deltaxrobot/Delta-X-3D-Printed-Parts/Delta-X-Robot/Delta X 1 - MainBox V2-1.STL

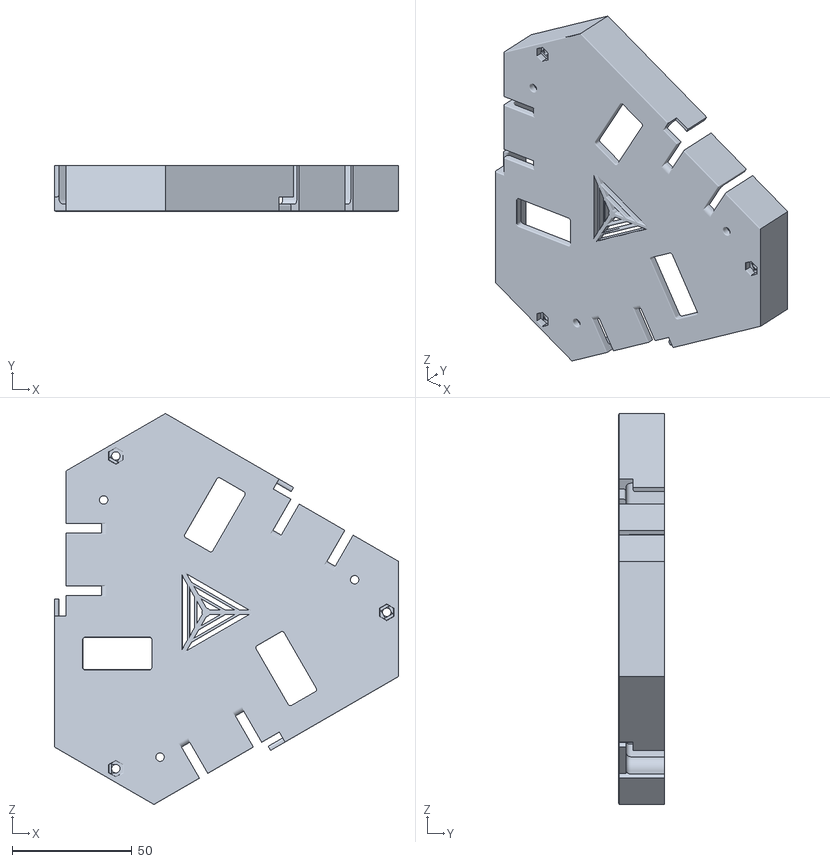
[picture p1: CAD file, 2022-04-01]
Delta-X-Robot/Delta X 1 - MainBox V2-1.STL
143.8 x 19.0 x 163.3
