deltaxrobot/Delta-X-3D-Printed-Parts/Delta-X-Robot/Delta X 1 - MainBoxLid V2-1.STL

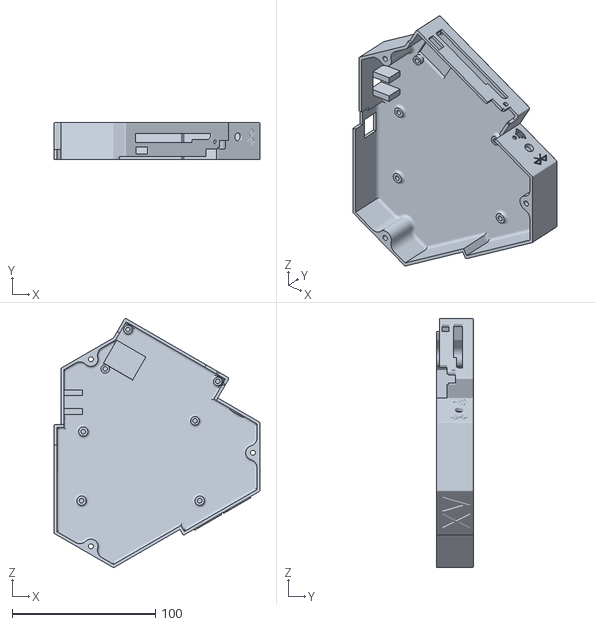
[picture p2: CAD file, 2022-04-01]
Delta-X-Robot/Delta X 1 - MainBoxLid V2-1.STL
143.8 x 25.8 x 173.8
