deltaxrobot/Delta-X-3D-Printed-Parts/Conveyor-X/RollerAxisHolder-Mirror.STL

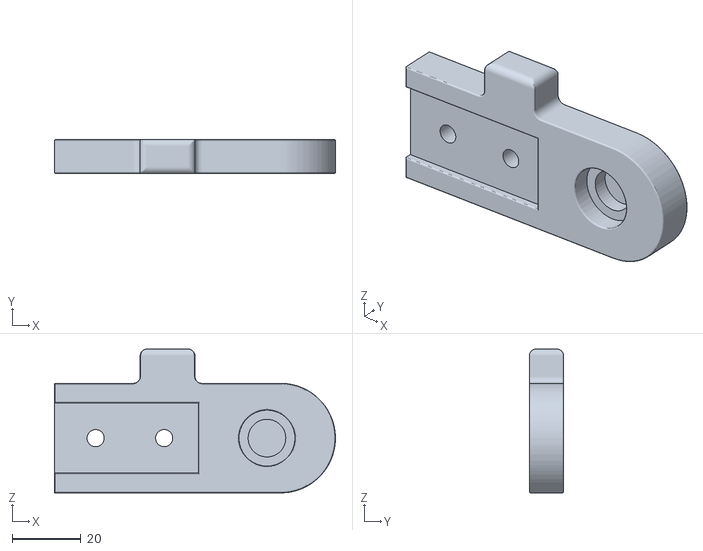
[picture p3: CAD file, 2023-01-11]
Conveyor-X/RollerAxisHolder-Mirror.STL
82.0 x 10.0 x 42.0
