deltaxrobot/Delta-X-3D-Printed-Parts/Delta-X-End-Effectors/Axis4 - Gripper/Axis4 Gripper Lib.STL

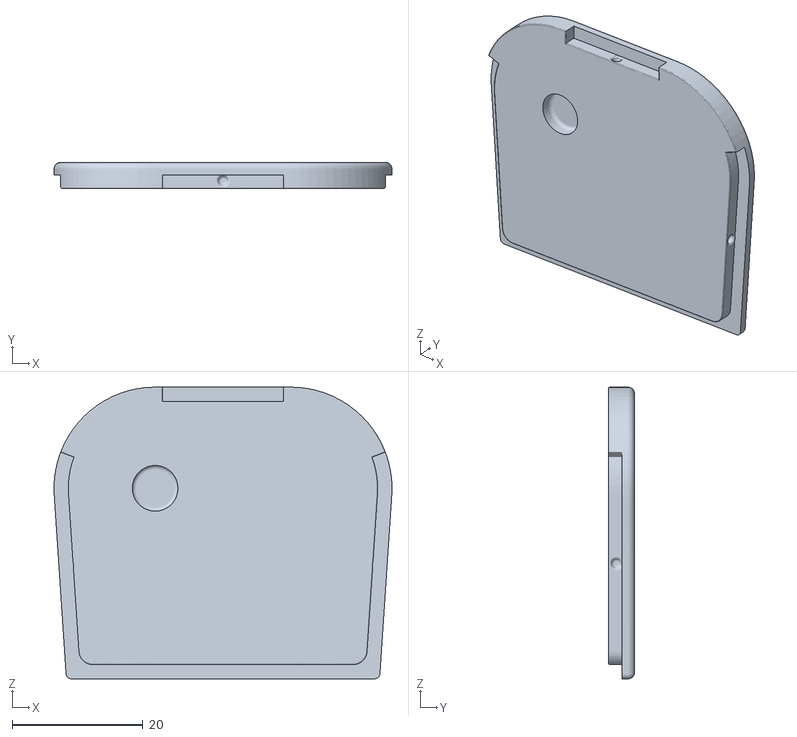
[picture p4: CAD file, 2020-04-02]
Delta-X-End-Effectors/Axis4 - Gripper/Axis4 Gripper Lib.STL
51.8 x 4.00 x 44.7
