deltaxrobot/Delta-X-3D-Printed-Parts/Delta-X-End-Effectors/Axis4 - Gripper/v2/Base-2.stl

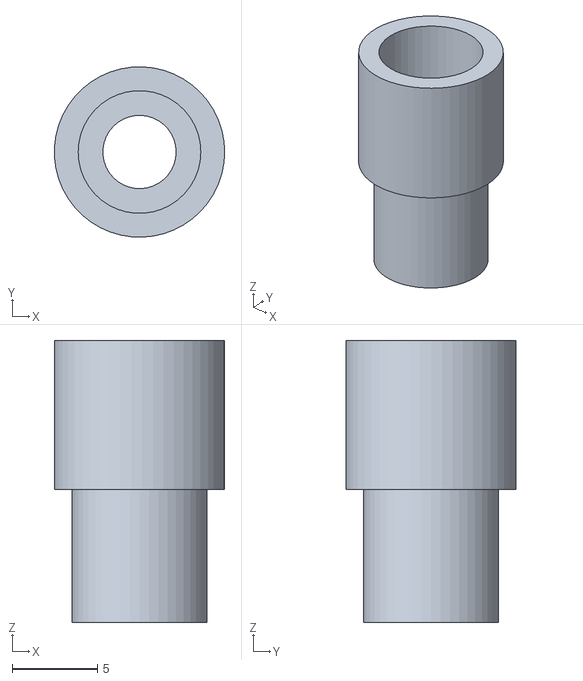
[picture p5: CAD file, 2023-02-06]
Delta-X-End-Effectors/Axis4 - Gripper/v2/Base-2.stl
10.0 x 9.99 x 16.6
