deltaxrobot/Delta-X-3D-Printed-Parts/Delta-X-End-Effectors/Flexible Gripper/Flexible Gripper _ 2 _plastic 3.STL

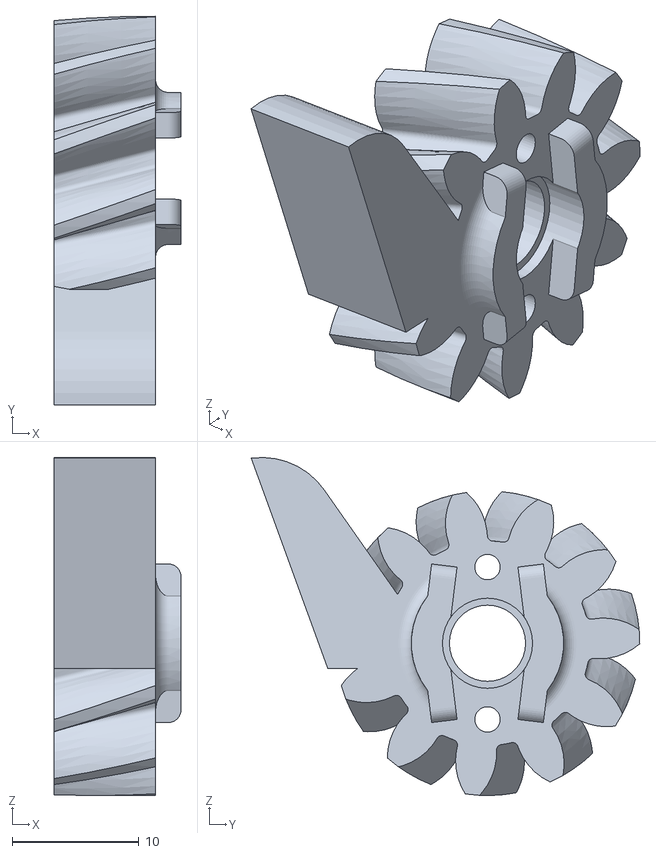
[picture p6: CAD file, 2020-04-02]
Delta-X-End-Effectors/Flexible Gripper/Flexible Gripper _ 2 _plastic 3.STL
10.00 x 30.6 x 26.6
