deltaxrobot/Delta-X-3D-Printed-Parts/Delta-X-End-Effectors/v2/Step-file/Pen Holder 2.STL

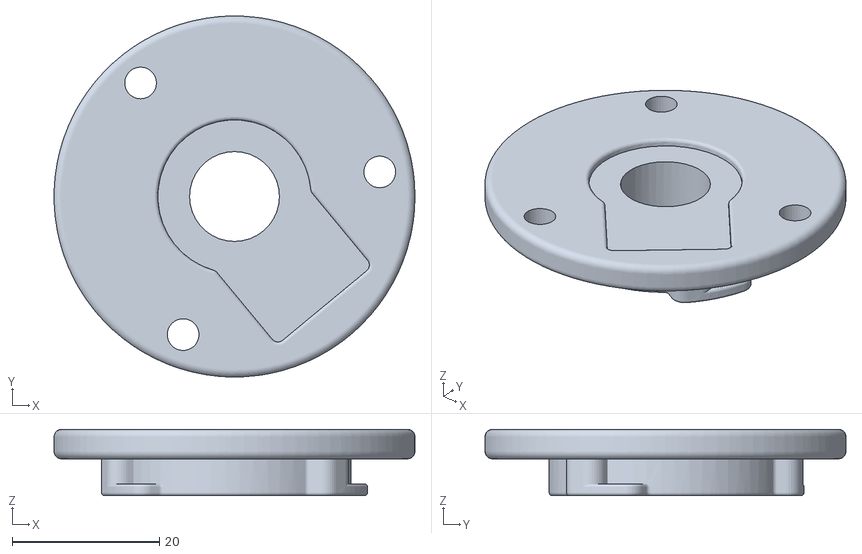
[picture p7: CAD file, 2024-02-09]
Delta-X-End-Effectors/v2/Step-file/Pen Holder 2.STL
49.0 x 49.0 x 9.00
