deltaxrobot/Delta-X-3D-Printed-Parts/Delta-X-End-Effectors/Vacuum/VaccumBox _1 .STL

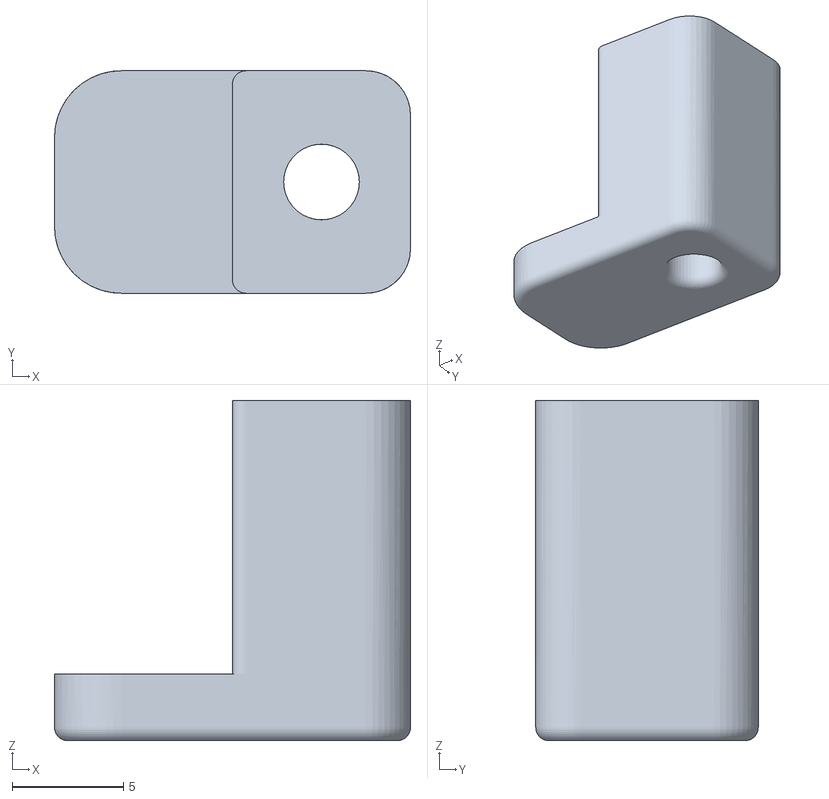
[picture p8: CAD file, 2020-04-02]
Delta-X-End-Effectors/Vacuum/VaccumBox _1 .STL
16.0 x 10.0 x 15.3
