deltaxrobot/Delta-X-3D-Printed-Parts/Delta-X-Robot/Delta X 1 - BeltTensioner2-2.STL

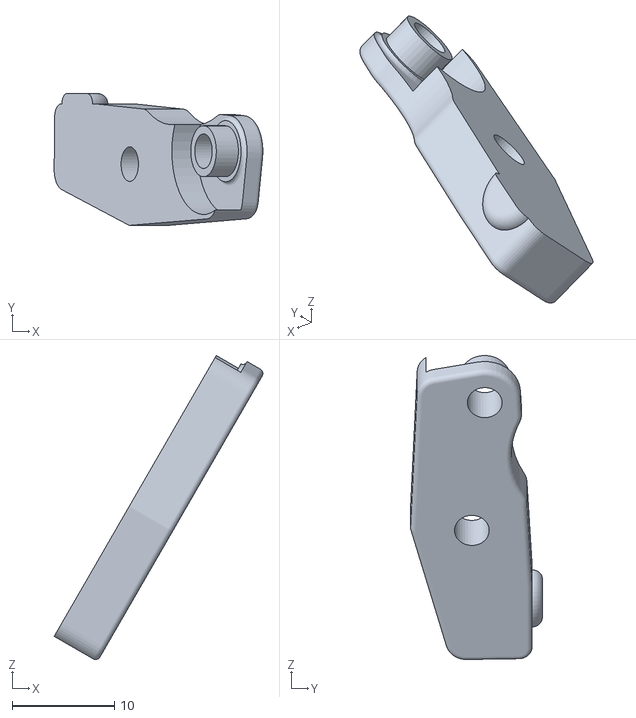
[picture p9: CAD file, 2022-04-01]
Delta-X-Robot/Delta X 1 - BeltTensioner2-2.STL
20.4 x 12.9 x 29.8
