deltaxrobot/Delta-X-3D-Printed-Parts/Slider-X/WheelHolder-1.STL

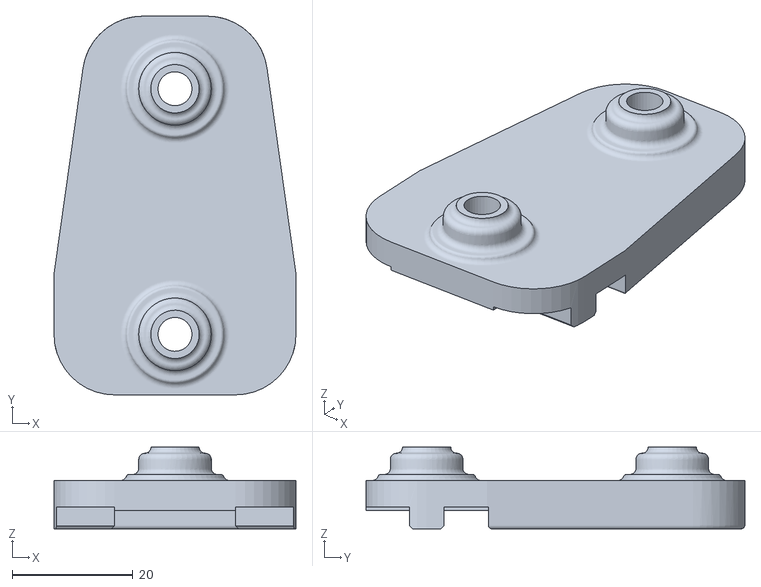
[picture p10: CAD file, 2023-01-11]
Slider-X/WheelHolder-1.STL
40.0 x 62.6 x 13.5
