deltaxrobot/Delta-X-3D-Printed-Parts/TripodBase.stl

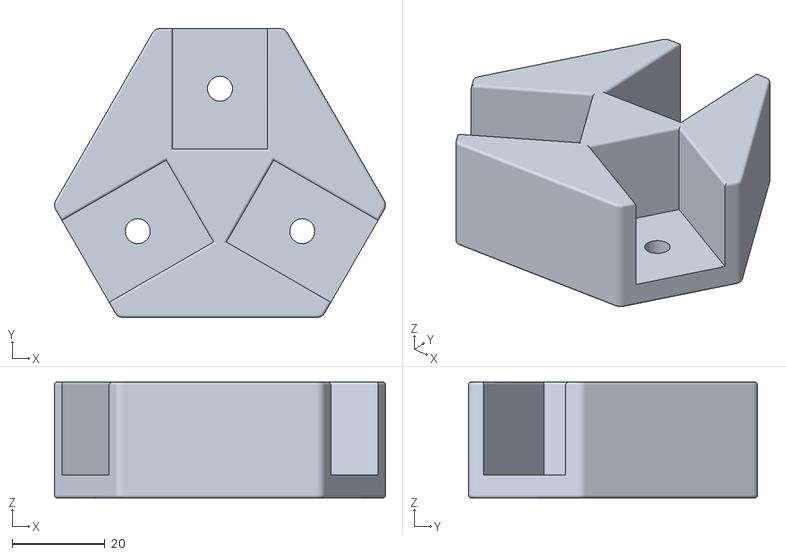
[picture p11: CAD file, 2024-03-16]
TripodBase.stl
71.4 x 62.4 x 25.0
