deltaxrobot/Delta-X-3D-Printed-Parts/Delta-X-End-Effectors/Axis4 - Gripper/v2/VaccumBase-SV.STL

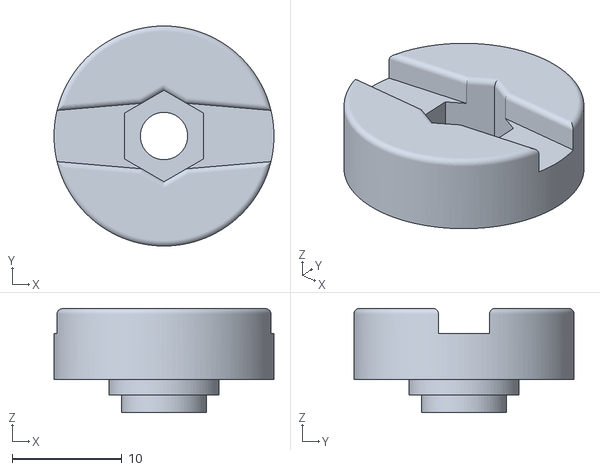
[picture p13: CAD file, 2023-02-06]
Delta-X-End-Effectors/Axis4 - Gripper/v2/VaccumBase-SV.STL
20.0 x 20.0 x 9.50
