deltaxrobot/Delta-X-3D-Printed-Parts/Delta-X-End-Effectors/Flexible Gripper/Flexible Gripper _ 2 _plastic.STL

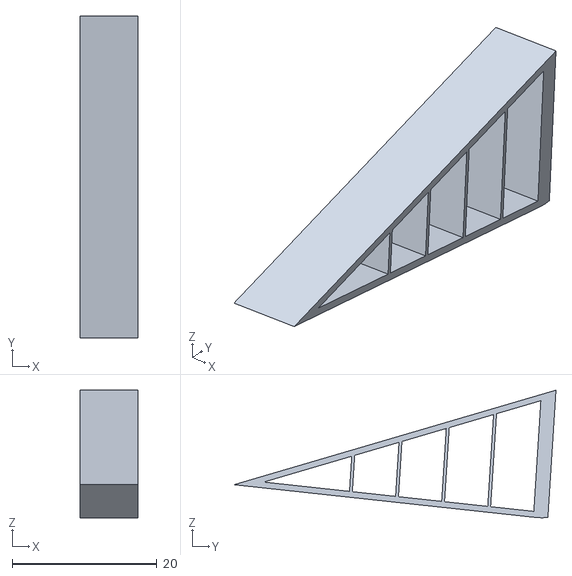
[picture p14: CAD file, 2020-04-02]
Delta-X-End-Effectors/Flexible Gripper/Flexible Gripper _ 2 _plastic.STL
8.00 x 44.5 x 17.7
