deltaxrobot/Delta-X-3D-Printed-Parts/Delta-X-End-Effectors/v2/Step-file/Pen Holder 1.STL

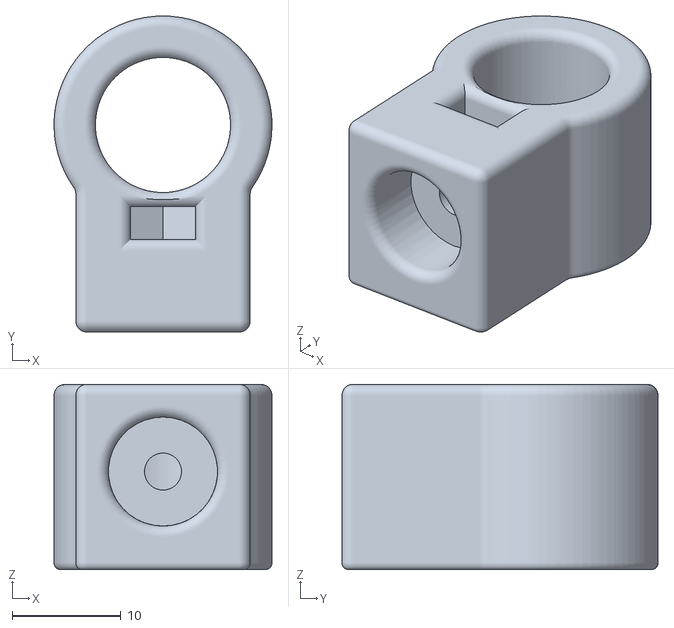
[picture p15: CAD file, 2024-02-09]
Delta-X-End-Effectors/v2/Step-file/Pen Holder 1.STL
20.0 x 29.0 x 17.0
