deltaxrobot/Delta-X-3D-Printed-Parts/Delta-X-End-Effectors/Vacuum/Axis4 - Vacuum Lib.STL

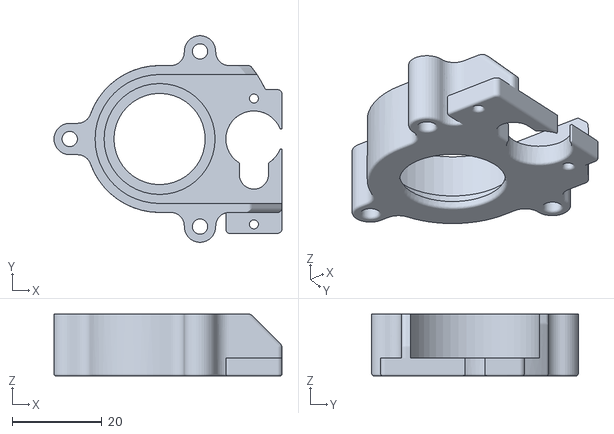
[picture p16: CAD file, 2020-04-02]
Delta-X-End-Effectors/Vacuum/Axis4 - Vacuum Lib.STL
50.8 x 46.0 x 13.8
