deltaxrobot/Delta-X-3D-Printed-Parts/Slider-X/RollerHolder.STL

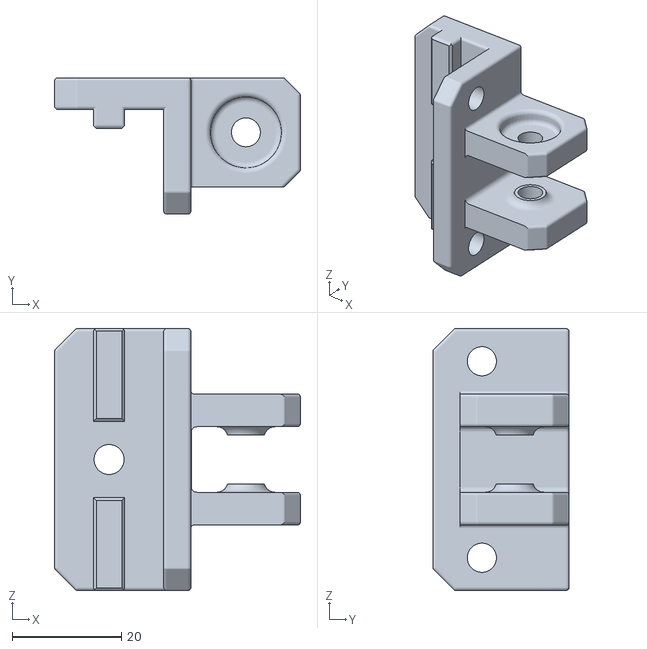
[picture p17: CAD file, 2023-01-11]
Slider-X/RollerHolder.STL
45.1 x 25.0 x 48.0
