deltaxrobot/Delta-X-3D-Printed-Parts/Conveyor-X/Adjust-Tool.STL

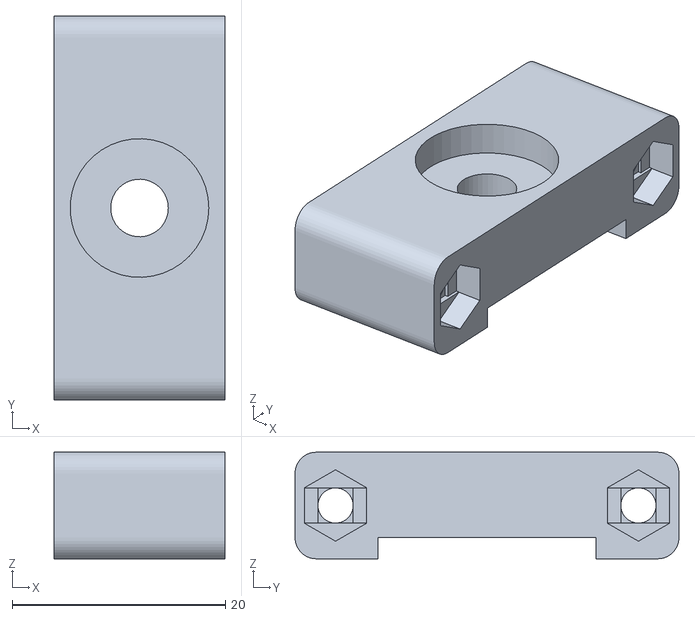
[picture p18: CAD file, 2023-01-11]
Conveyor-X/Adjust-Tool.STL
16.0 x 36.0 x 10.0
