deltaxrobot/Delta-X-3D-Printed-Parts/Delta-X-End-Effectors/Axis4 - Gripper/Axis4 Gripper Box.STL

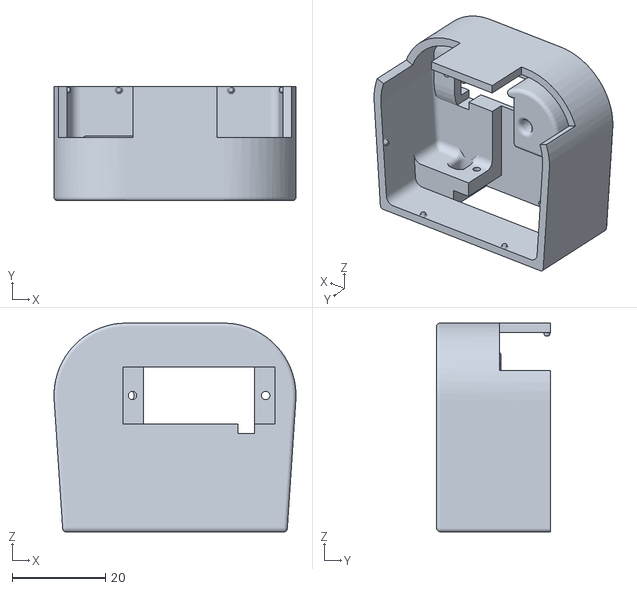
[picture p19: CAD file, 2020-04-02]
Delta-X-End-Effectors/Axis4 - Gripper/Axis4 Gripper Box.STL
51.8 x 24.5 x 44.7
