deltaxrobot/Delta-X-3D-Printed-Parts/Delta-X-End-Effectors/Axis4 - Gripper/v2/Bearing.STL

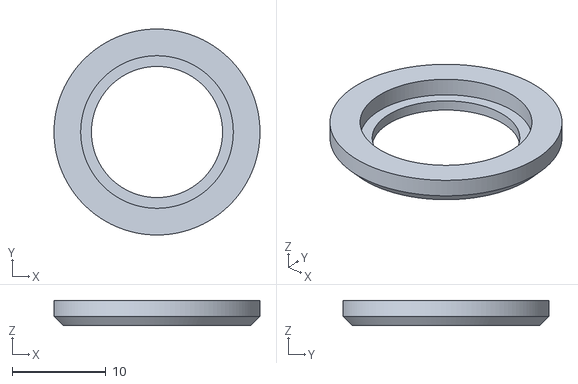
[picture p20: CAD file, 2023-02-06]
Delta-X-End-Effectors/Axis4 - Gripper/v2/Bearing.STL
22.0 x 22.0 x 2.70
