deltaxrobot/Delta-X-3D-Printed-Parts/Delta-X-End-Effectors/Flexible Gripper/Flexible Gripper Lib.STL

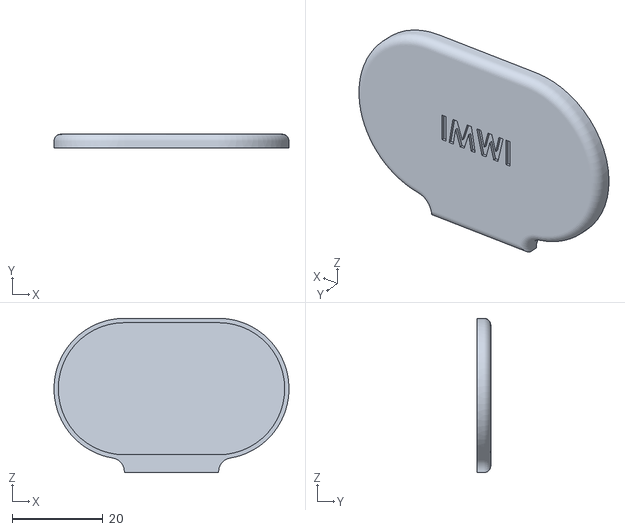
[picture p21: CAD file, 2020-04-02]
Delta-X-End-Effectors/Flexible Gripper/Flexible Gripper Lib.STL
51.8 x 3.00 x 34.0
