deltaxrobot/Delta-X-3D-Printed-Parts/Delta-X-End-Effectors/v2/Step-file/RodEnd V2.STL

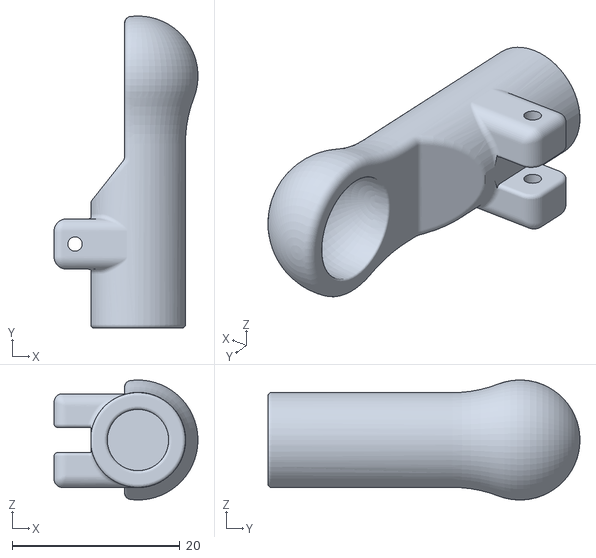
[picture p22: CAD file, 2022-10-25]
Delta-X-End-Effectors/v2/Step-file/RodEnd V2.STL
17.1 x 37.1 x 14.3
