deltaxrobot/Delta-X-3D-Printed-Parts/Delta-X-End-Effectors/Vacuum/ISO - Spur gear 1.5M 14T Servo.STL

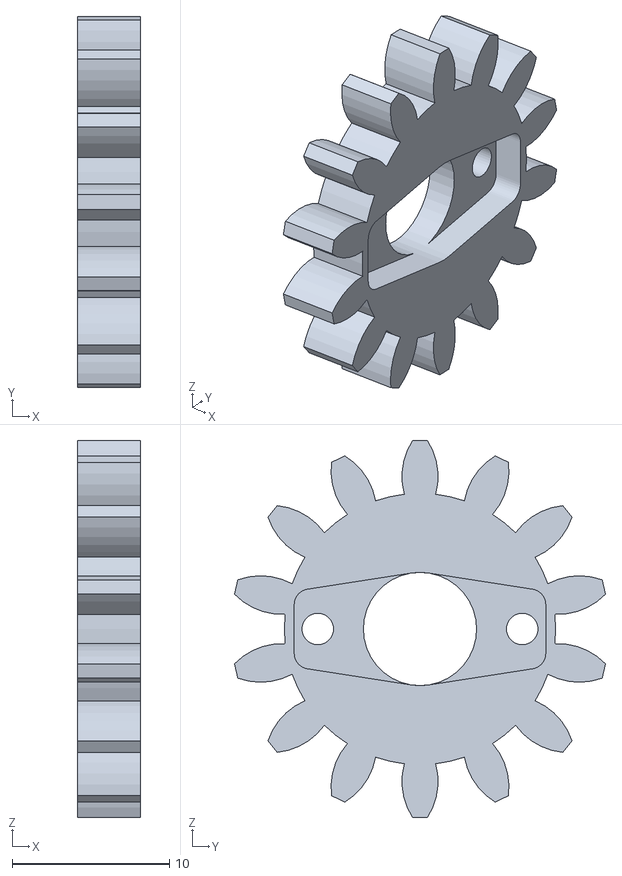
[picture p23: CAD file, 2020-04-02]
Delta-X-End-Effectors/Vacuum/ISO - Spur gear 1.5M 14T Servo.STL
4.00 x 23.6 x 24.0
