deltaxrobot/Delta-X-3D-Printed-Parts/Conveyor-X/ConveyorGearBox-Lid.STL

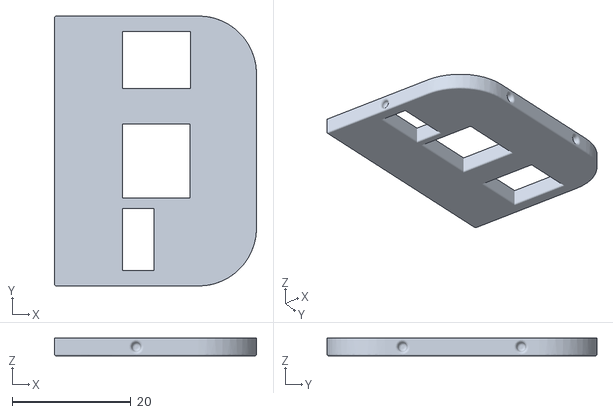
[picture p24: CAD file, 2023-01-11]
Conveyor-X/ConveyorGearBox-Lid.STL
34.0 x 45.5 x 3.00
