deltaxrobot/Delta-X-3D-Printed-Parts/Delta-X-End-Effectors/Axis4 - Gripper/Axis4 Gripper Top.STL

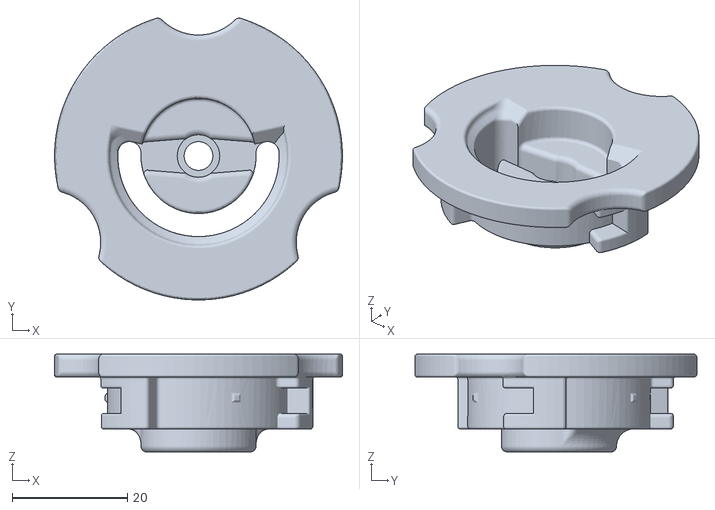
[picture p25: CAD file, 2020-04-02]
Delta-X-End-Effectors/Axis4 - Gripper/Axis4 Gripper Top.STL
50.0 x 48.9 x 17.0
