deltaxrobot/Delta-X-3D-Printed-Parts/Delta-X-End-Effectors/Axis4 - Gripper/v2/Base-1.stl

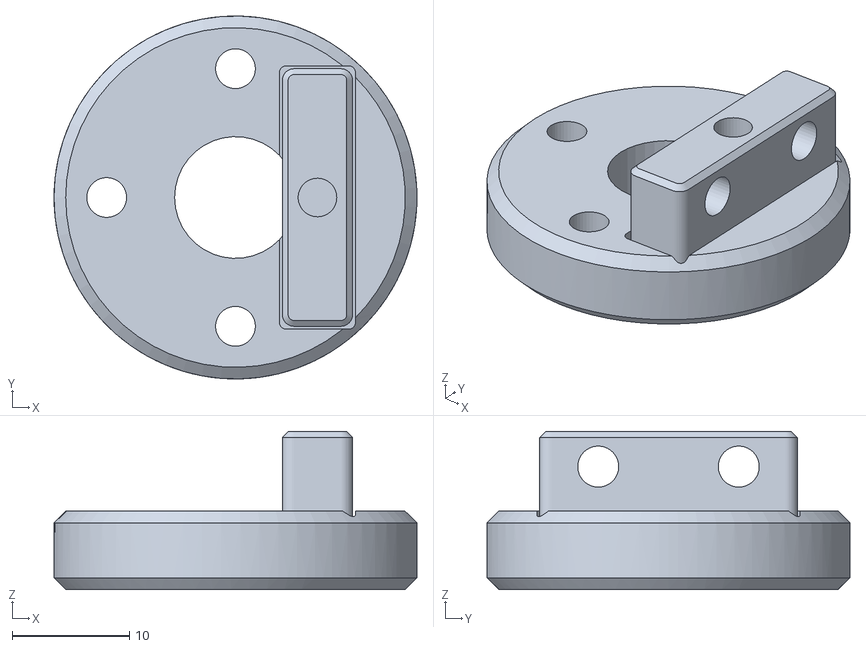
[picture p26: CAD file, 2023-02-06]
Delta-X-End-Effectors/Axis4 - Gripper/v2/Base-1.stl
31.0 x 31.0 x 13.5
