deltaxrobot/Delta-X-3D-Printed-Parts/Delta-X-End-Effectors/Flexible Gripper/Flexible Gripper _ 2 _plastic 1.STL

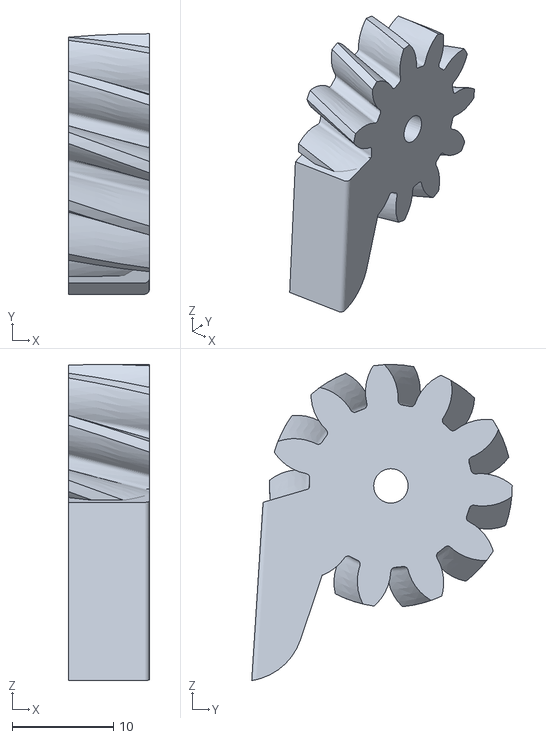
[picture p27: CAD file, 2020-04-02]
Delta-X-End-Effectors/Flexible Gripper/Flexible Gripper _ 2 _plastic 1.STL
8.00 x 25.7 x 31.2
