deltaxrobot/Delta-X-3D-Printed-Parts/Delta-X-End-Effectors/v2/Step-file/3D Printing head.STEP

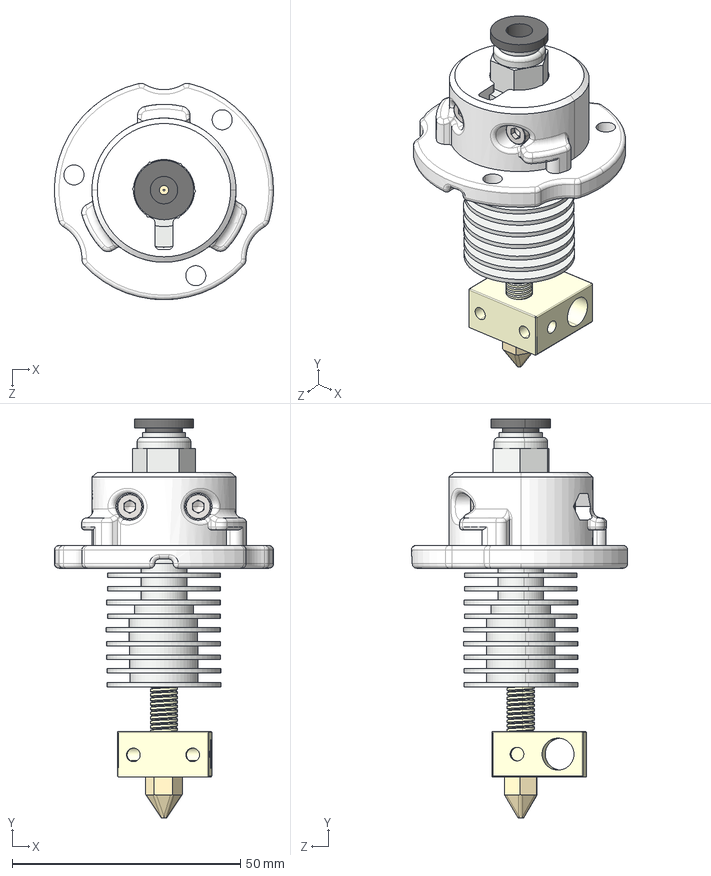
[picture p28: CAD file, 2022-04-01]
Delta-X-End-Effectors/v2/Step-file/3D Printing head.STEP
48.0 x 87.4 x 47.4 mm
Base 3D printer
J Type Extruder
Throat
Heat Block
Extruder Nozzle
ISO - 4032 - M3 - D - N_Hex nut M3 x 2
M3 x 20 Hex Bolt_M3 x 20 Hex Bolt x 2
