deltaxrobot/Delta-X-3D-Printed-Parts/Delta-X-End-Effectors/Vacuum/Vaccum Jig.STL

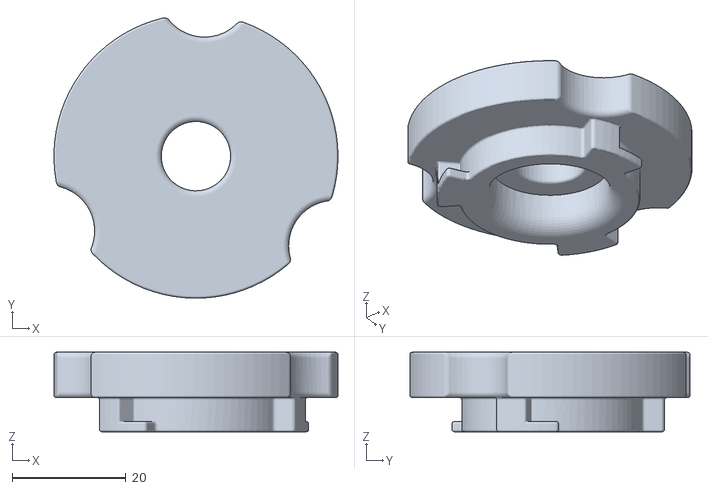
[picture p29: CAD file, 2020-04-02]
Delta-X-End-Effectors/Vacuum/Vaccum Jig.STL
50.0 x 49.4 x 14.0
