deltaxrobot/Delta-X-3D-Printed-Parts/Slider-X/WheelHolder-2.STL

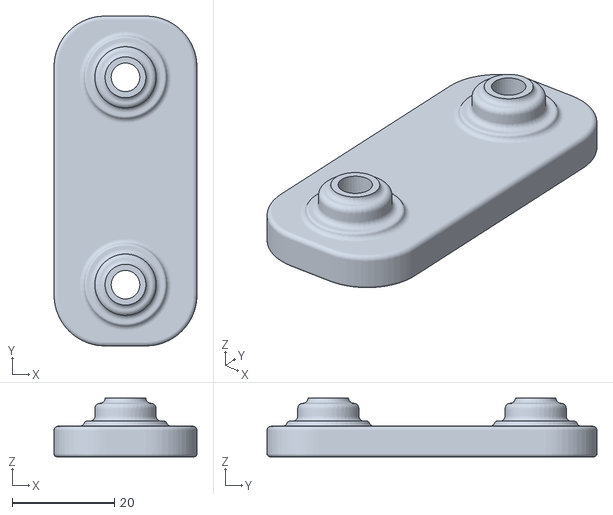
[picture p30: CAD file, 2023-01-11]
Slider-X/WheelHolder-2.STL
28.0 x 64.6 x 11.5
