deltaxrobot/Delta-X-3D-Printed-Parts/Conveyor-X/ConveyorGearBox-Body.STL

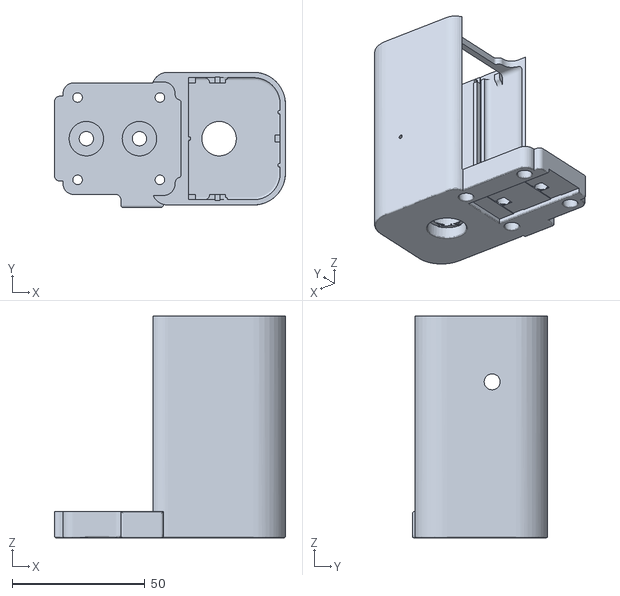
[picture p31: CAD file, 2023-01-11]
Conveyor-X/ConveyorGearBox-Body.STL
87.0 x 51.0 x 83.5
