deltaxrobot/Delta-X-3D-Printed-Parts/Delta-X-End-Effectors/Axis4 - Gripper/RH Helical gear 1.75M 11T.STL

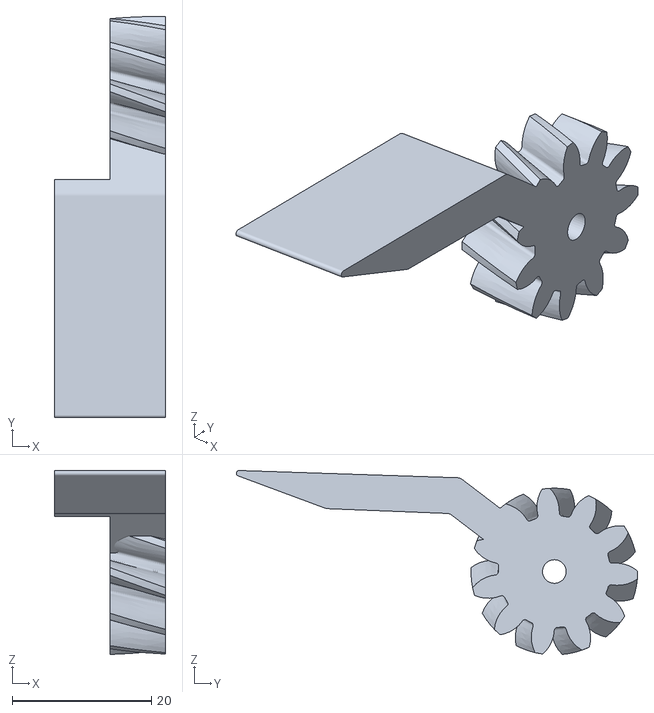
[picture p32: CAD file, 2020-04-02]
Delta-X-End-Effectors/Axis4 - Gripper/RH Helical gear 1.75M 11T.STL
16.0 x 57.7 x 26.5
