deltaxrobot/Delta-X-3D-Printed-Parts/Delta-X-End-Effectors/Axis4 - Gripper/v2/Axis4-Vacuum-Bottom-SV.stl

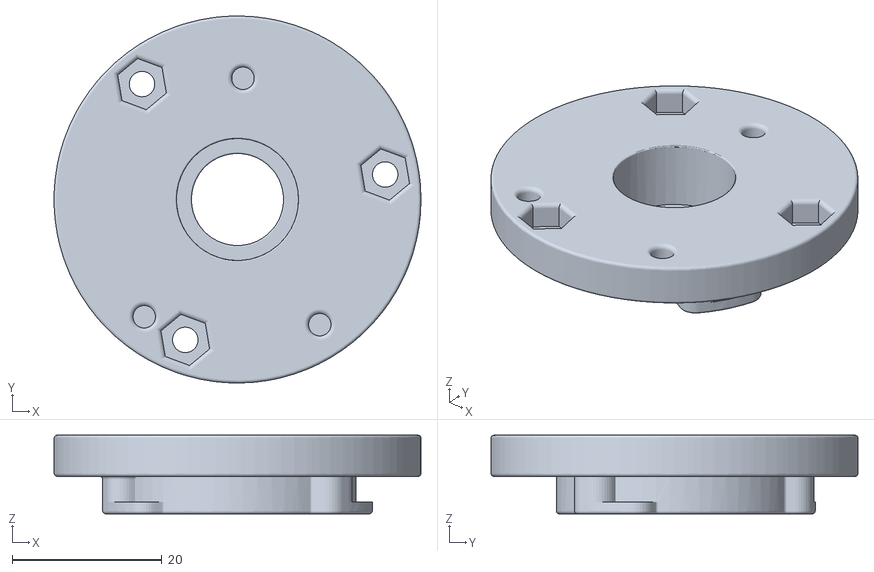
[picture p33: CAD file, 2023-02-06]
Delta-X-End-Effectors/Axis4 - Gripper/v2/Axis4-Vacuum-Bottom-SV.stl
49.0 x 49.0 x 10.5
