deltaxrobot/Delta-X-3D-Printed-Parts/Delta-X-End-Effectors/Flexible Gripper/Flexible Gripper Top.STL

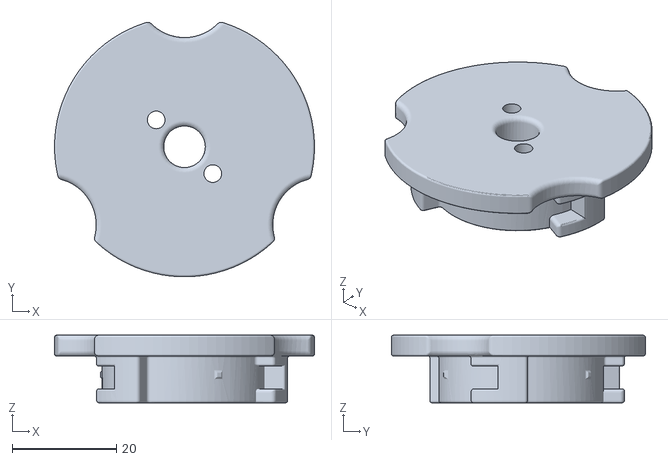
[picture p34: CAD file, 2020-04-02]
Delta-X-End-Effectors/Flexible Gripper/Flexible Gripper Top.STL
50.0 x 48.9 x 13.0
