deltaxrobot/Delta-X-3D-Printed-Parts/Delta-X-End-Effectors/v2/Step-file/Laser Module.STEP

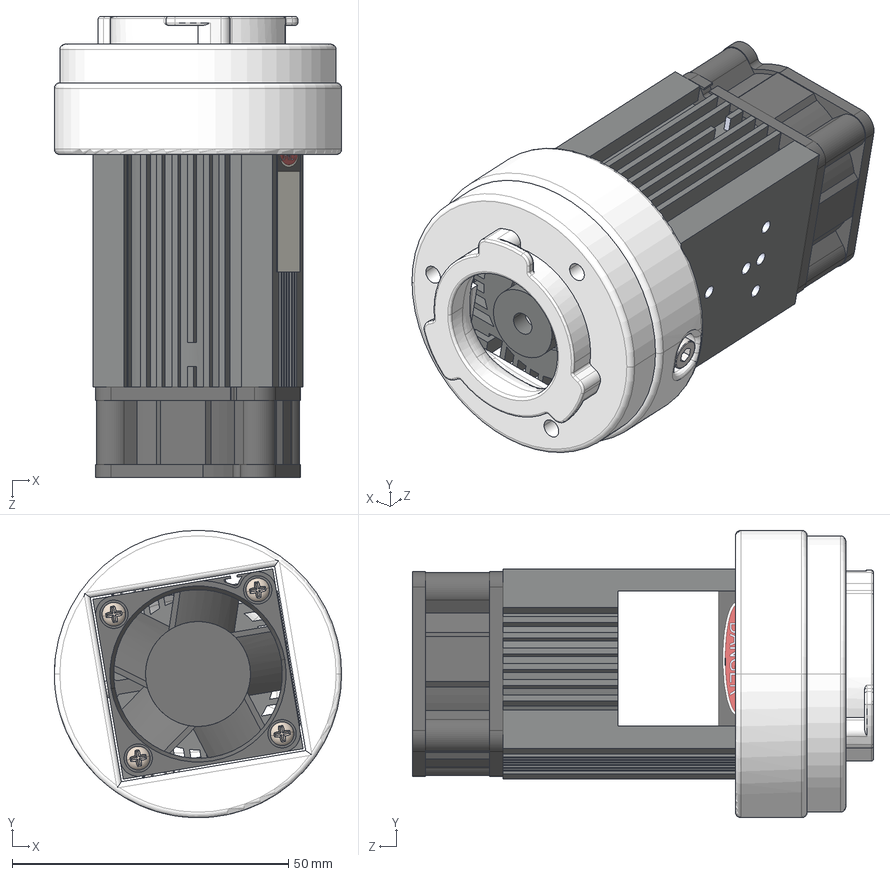
[picture p35: CAD file, 2022-04-01]
Delta-X-End-Effectors/v2/Step-file/Laser Module.STEP
52.0 x 52.0 x 83.4 mm
Base Laser V1
LASER 500mW_Predeterminado
M3 Hex Nut_Hex Nut M3 x 3
M3 x 12 Hex Bolt_Hex Bolt M3 x 12
