deltaxrobot/Delta-X-3D-Printed-Parts/Delta-X-End-Effectors/Vacuum/VaccumBox.STEP

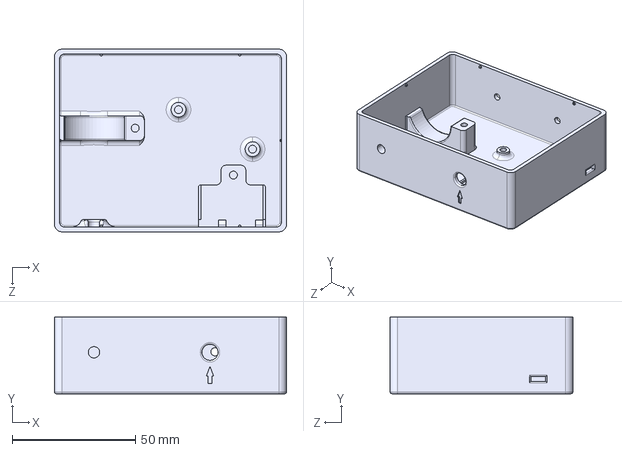
[picture p36: CAD file, 2020-04-02]
Delta-X-End-Effectors/Vacuum/VaccumBox.STEP
94.0 x 31.0 x 74.0 mm
