deltaxrobot/Delta-X-3D-Printed-Parts/Slider-X/BeltKeeper.STL

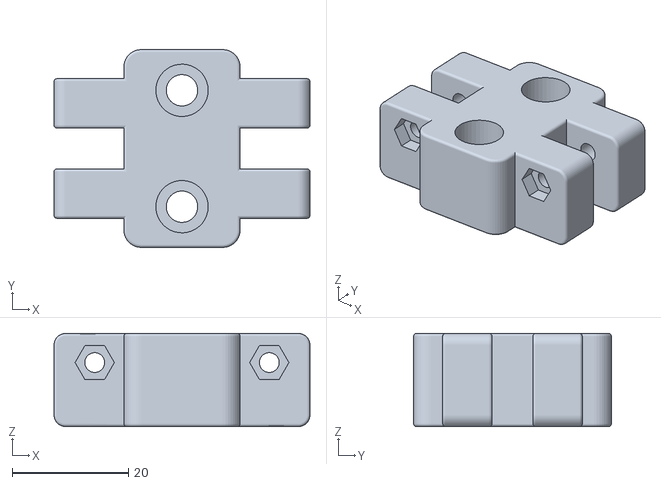
[picture p37: CAD file, 2023-01-11]
Slider-X/BeltKeeper.STL
44.0 x 34.0 x 16.0
