deltaxrobot/Delta-X-3D-Printed-Parts/Conveyor-X/Roller.STL

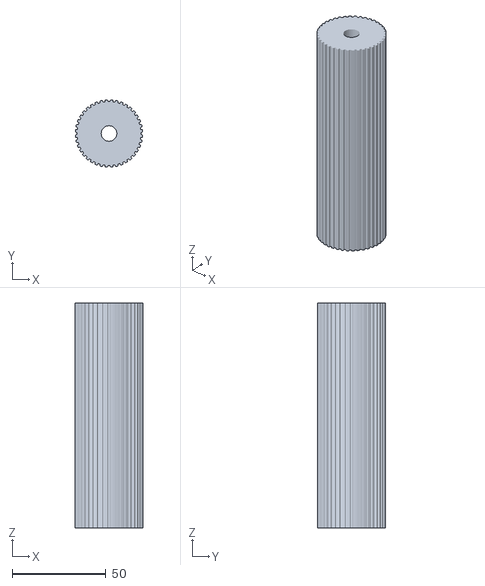
[picture p38: CAD file, 2023-01-11]
Conveyor-X/Roller.STL
36.0 x 36.0 x 119.8
