deltaxrobot/Delta-X-3D-Printed-Parts/Delta-X-End-Effectors/v2/Step-file/Pen.STEP

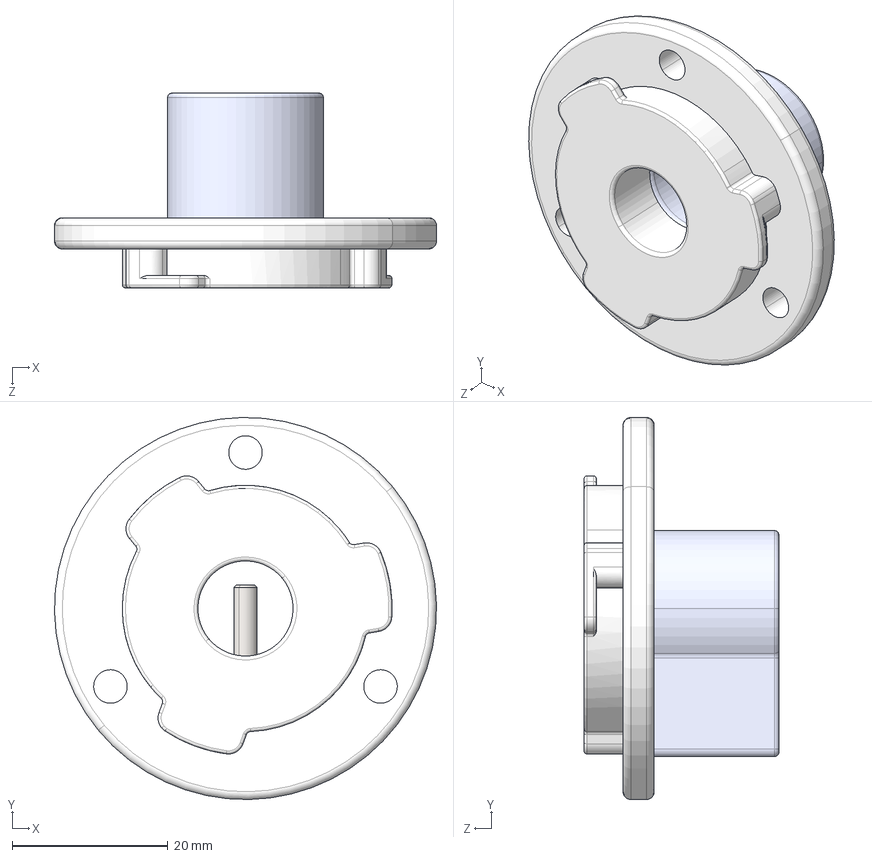
[picture p40: CAD file, 2022-04-01]
Delta-X-End-Effectors/v2/Step-file/Pen.STEP
49.0 x 49.0 x 25.0 mm
Pen Holder 1
Pen Holder 2
Hex Bolt M3 x 16_Hex Bolt M3 x 16
M3 Hex Nut_Hex Nut M3
