deltaxrobot/Delta-X-3D-Printed-Parts/Delta-X-End-Effectors/Vacuum/LidVaccumBox.STL

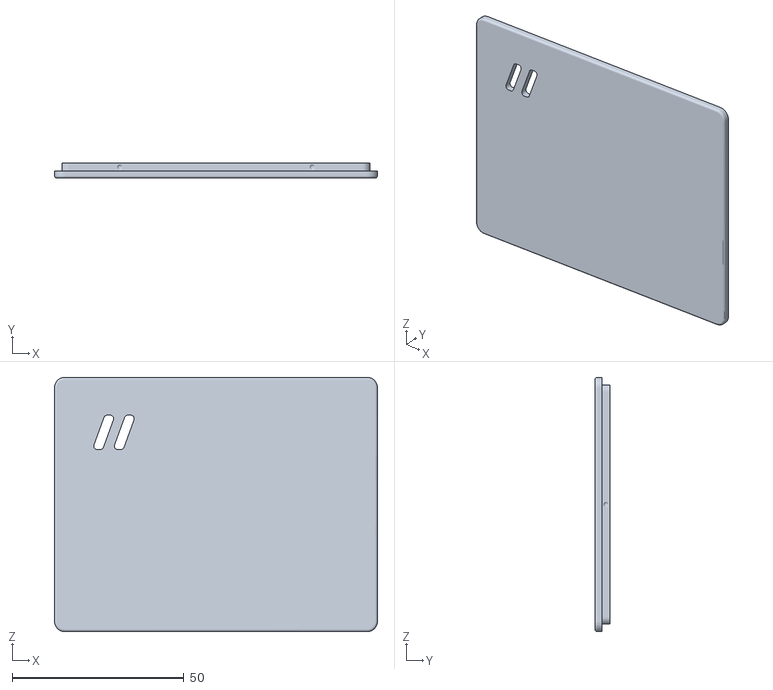
[picture p41: CAD file, 2020-04-02]
Delta-X-End-Effectors/Vacuum/LidVaccumBox.STL
94.0 x 4.40 x 74.0
