deltaxrobot/Delta-X-3D-Printed-Parts/Conveyor-X/StepperWedge.STL

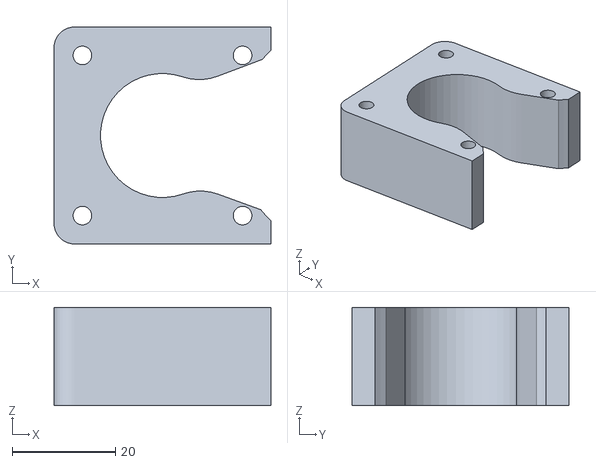
[picture p42: CAD file, 2023-01-11]
Conveyor-X/StepperWedge.STL
42.0 x 42.0 x 19.0
