deltaxrobot/Delta-X-3D-Printed-Parts/Delta-X-End-Effectors/v2/Step-file/Double Suction Cup.STEP

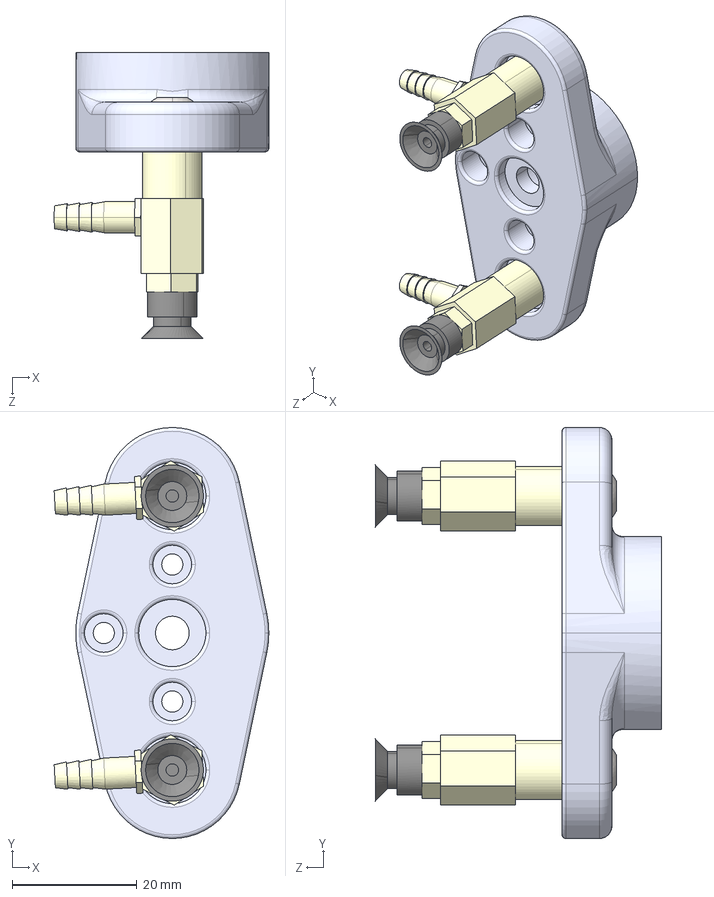
[picture p43: CAD file, 2022-04-01]
Delta-X-End-Effectors/v2/Step-file/Double Suction Cup.STEP
34.5 x 66.0 x 46.0 mm
Suction Head x 2
M5 x 10 Hex Bolt_M5 x 10 Hex Bolt x 2
GanDauHutKep
