deltaxrobot/Delta-X-3D-Printed-Parts/Delta-X-End-Effectors/Vacuum/ISO - Spur gear 1.5M 14T 14.5PA.STL

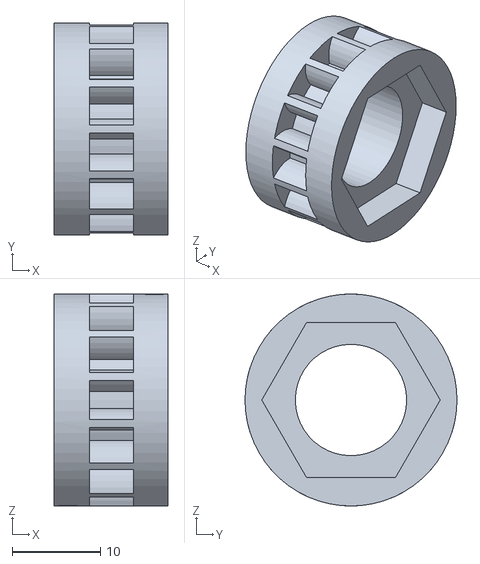
[picture p44: CAD file, 2020-04-02]
Delta-X-End-Effectors/Vacuum/ISO - Spur gear 1.5M 14T 14.5PA.STL
12.9 x 24.0 x 24.0
