deltaxrobot/Delta-X-3D-Printed-Parts/Delta-X-End-Effectors/Vacuum/Axis4 - Vacuum Bottom.STL

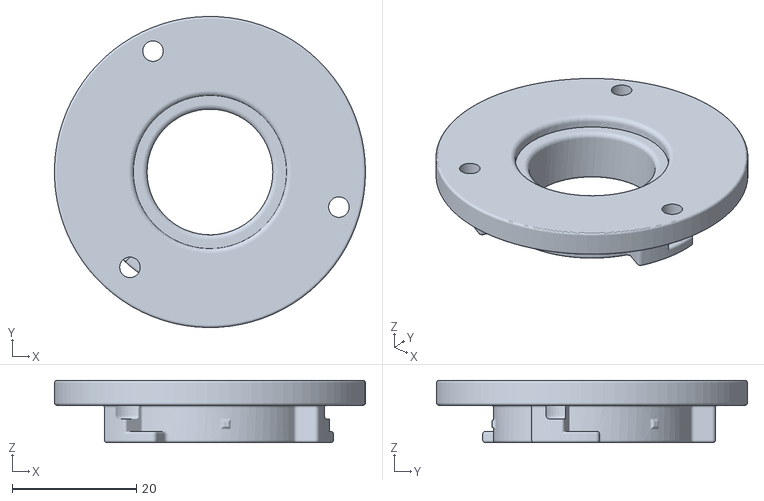
[picture p46: CAD file, 2020-04-02]
Delta-X-End-Effectors/Vacuum/Axis4 - Vacuum Bottom.STL
50.0 x 50.0 x 10.0
