deltaxrobot/Delta-X-3D-Printed-Parts/Delta-X-End-Effectors/v2/Step-file/Single Suction Cup.STEP

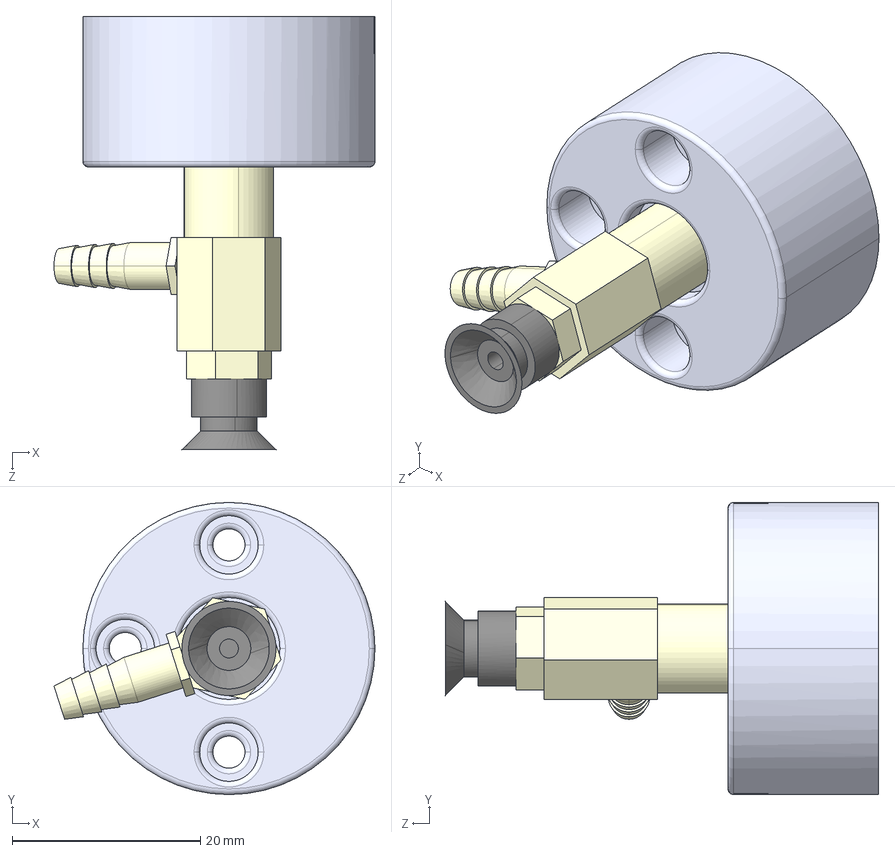
[picture p47: CAD file, 2022-04-01]
Delta-X-End-Effectors/v2/Step-file/Single Suction Cup.STEP
34.1 x 31.0 x 46.0 mm
GanDauHutDon
Suction Head
M5 x 10 Hex Bolt_M5 x 10 Hex Bolt
