deltaxrobot/Delta-X-3D-Printed-Parts/Delta-X-End-Effectors/Vacuum/VaccumBox _ 2.STL

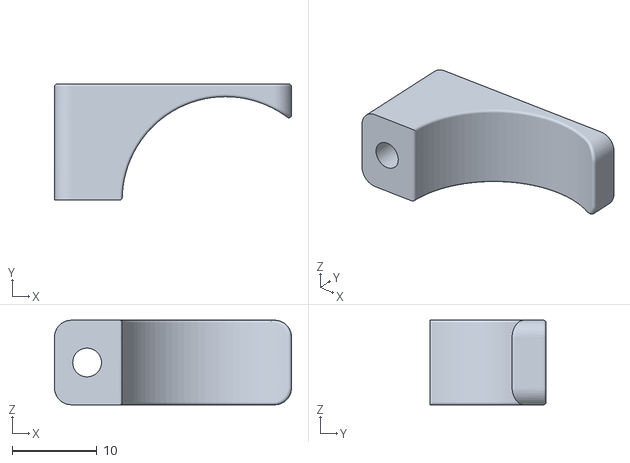
[picture p48: CAD file, 2020-04-02]
Delta-X-End-Effectors/Vacuum/VaccumBox _ 2.STL
28.0 x 13.7 x 10.00
