deltaxrobot/Delta-X-3D-Printed-Parts/Delta-X-Robot/Delta X 1 - Outer Arm-6 Joint Ball-2.STL

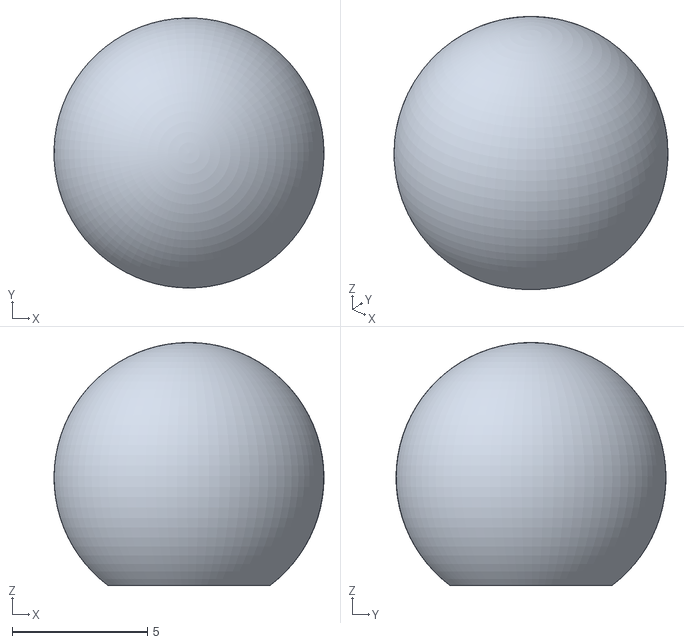
[picture p49: CAD file, 2022-04-01]
Delta-X-Robot/Delta X 1 - Outer Arm-6 Joint Ball-2.STL
10.00 x 10.00 x 9.00
