deltaxrobot/Delta-X-3D-Printed-Parts/Delta-X-Robot/Delta X 1 - ArmSpring-5.STL

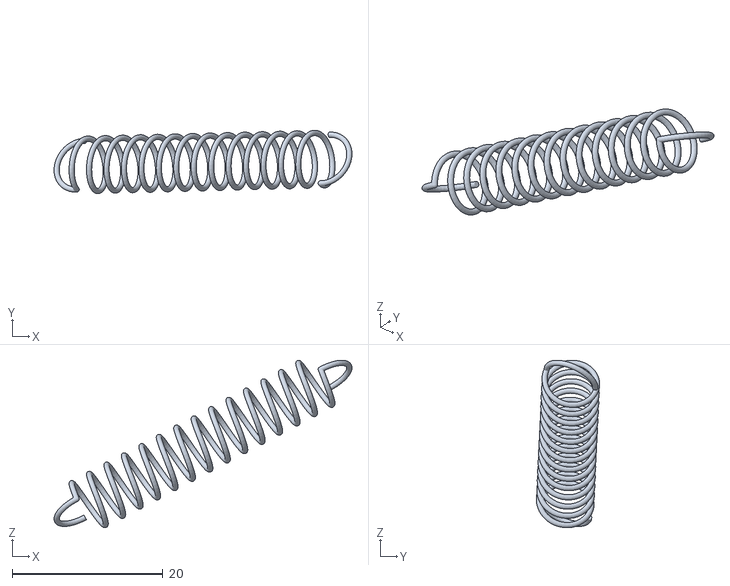
[picture p50: CAD file, 2022-04-01]
Delta-X-Robot/Delta X 1 - ArmSpring-5.STL
39.6 x 8.42 x 22.2
