deltaxrobot/Delta-X-3D-Printed-Parts/Delta-X-Robot/Delta X 1 - MovingBase-4 M4x60 thread-1.STL

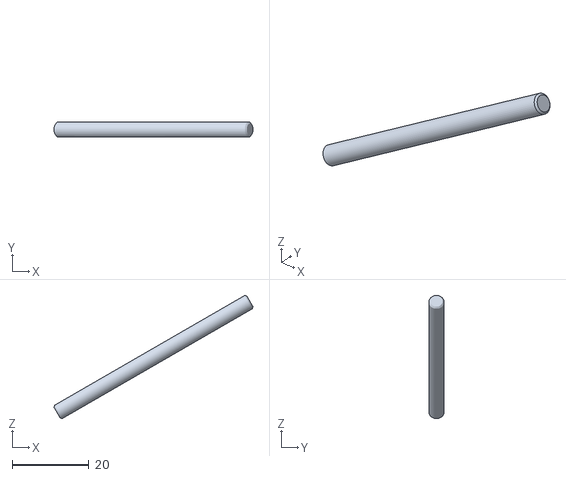
[picture p51: CAD file, 2022-04-01]
Delta-X-Robot/Delta X 1 - MovingBase-4 M4x60 thread-1.STL
51.8 x 4.00 x 32.1
