deltaxrobot/Delta-X-3D-Printed-Parts/Delta-X-Robot/Delta X 1 - Outer Arm-2 Shoulder-1.STL

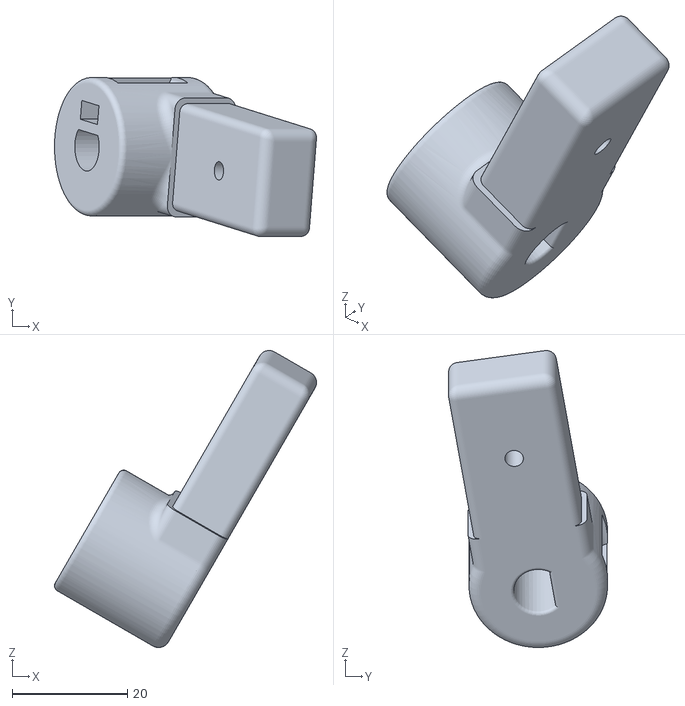
[picture p52: CAD file, 2022-04-01]
Delta-X-Robot/Delta X 1 - Outer Arm-2 Shoulder-1.STL
45.4 x 27.5 x 51.5
