deltaxrobot/Delta-X-3D-Printed-Parts/Delta-X-Robot/Delta X 1 - OuterArm1-17 RodEnd-1-V2-1.STL

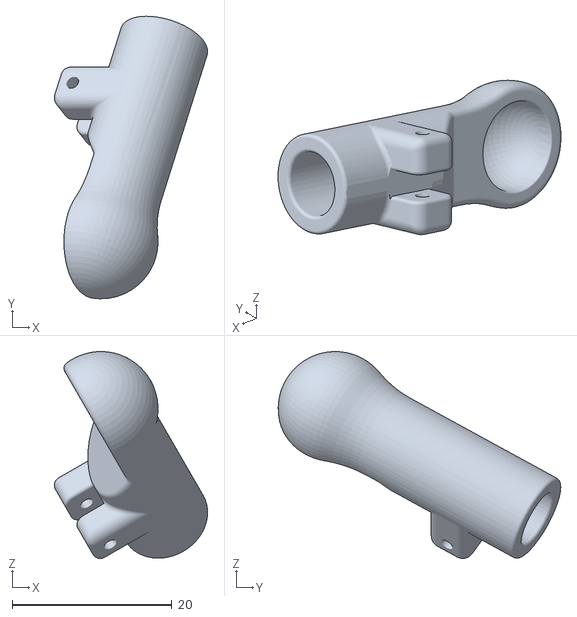
[picture p53: CAD file, 2022-04-01]
Delta-X-Robot/Delta X 1 - OuterArm1-17 RodEnd-1-V2-1.STL
19.2 x 35.4 x 25.9
