deltaxrobot/Delta-X-3D-Printed-Parts/Delta-X-Robot/Delta X 1 - OuterArm1-16 RodEnd-1-V2-1.STL

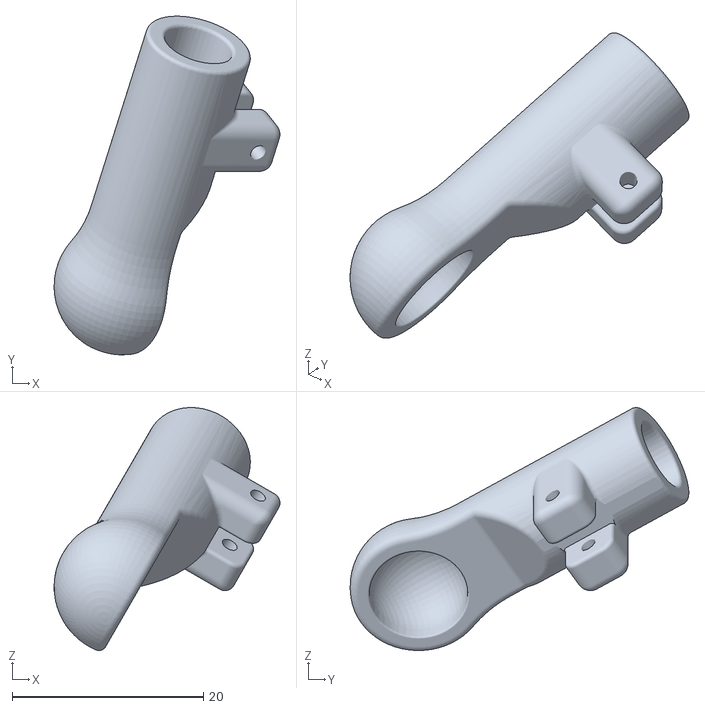
[picture p54: CAD file, 2022-04-01]
Delta-X-Robot/Delta X 1 - OuterArm1-16 RodEnd-1-V2-1.STL
23.6 x 35.4 x 25.4
