deltaxrobot/Delta-X-3D-Printed-Parts/Delta-X-Robot/Delta X 1 - BeltTensioner2-1.STL

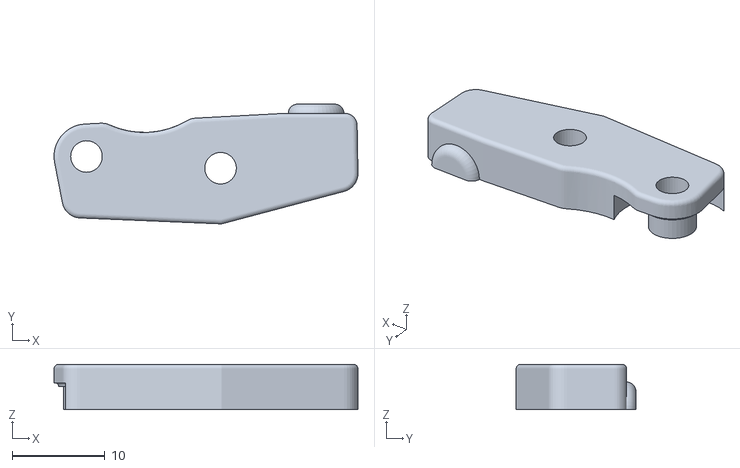
[picture p55: CAD file, 2022-04-01]
Delta-X-Robot/Delta X 1 - BeltTensioner2-1.STL
32.7 x 12.9 x 4.90
