deltaxrobot/Delta-X-3D-Printed-Parts/Delta-X-Robot/Delta X 1 - OuterArm1-18 Spring Stick-1.STL

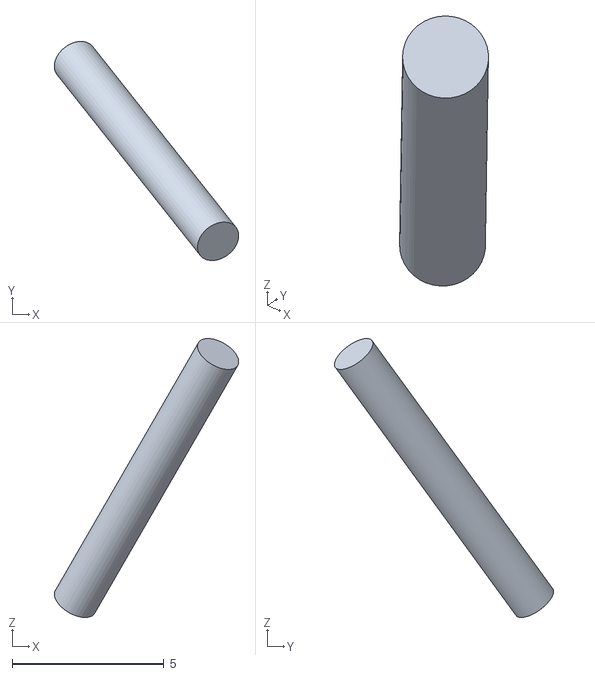
[picture p56: CAD file, 2022-04-01]
Delta-X-Robot/Delta X 1 - OuterArm1-18 Spring Stick-1.STL
6.07 x 7.22 x 9.19
