deltaxrobot/Delta-X-3D-Printed-Parts/Delta-X-Robot/Delta X 1 - OuterArm1-14 Spring Stick-1.STL

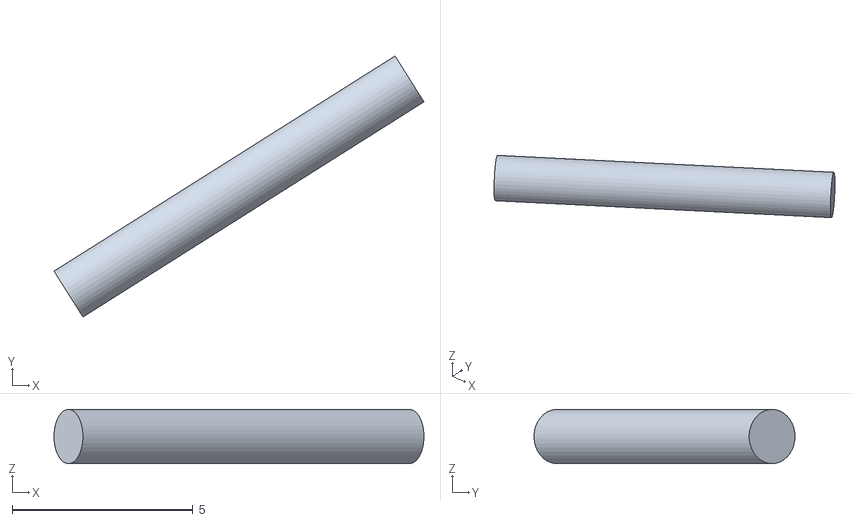
[picture p57: CAD file, 2022-04-01]
Delta-X-Robot/Delta X 1 - OuterArm1-14 Spring Stick-1.STL
10.2 x 7.22 x 1.50
