deltaxrobot/Delta-X-3D-Printed-Parts/Delta-X-Robot/Delta X 1 - BeltTensioner2-3.STL

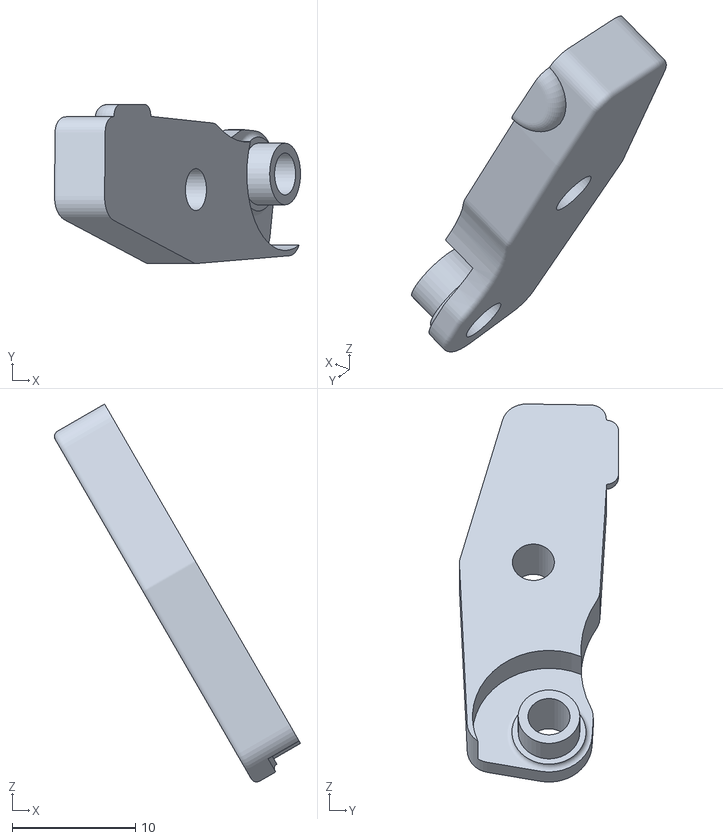
[picture p58: CAD file, 2022-04-01]
Delta-X-Robot/Delta X 1 - BeltTensioner2-3.STL
19.9 x 12.9 x 30.6
