deltaxrobot/Delta-X-3D-Printed-Parts/Delta-X-Robot/Delta X 1 - OuterArm1-19 cacbon-1.STL

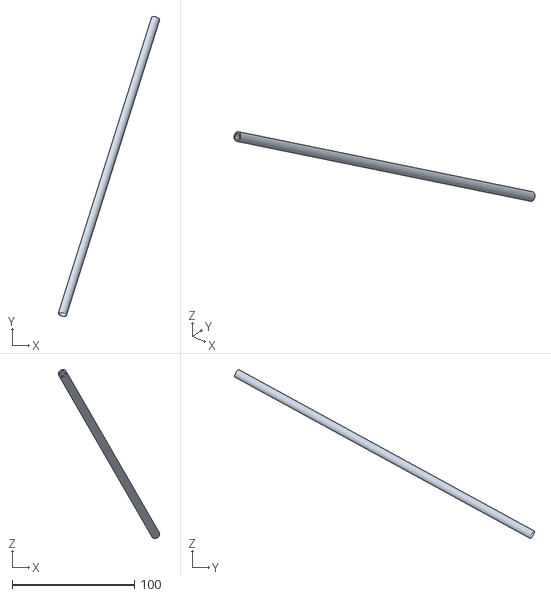
[picture p59: CAD file, 2022-04-01]
Delta-X-Robot/Delta X 1 - OuterArm1-19 cacbon-1.STL
83.0 x 245.6 x 138.4
