deltaxrobot/Delta-X-3D-Printed-Parts/Delta-X-Robot/Delta X 1 - GT2_20T_5-6.STL

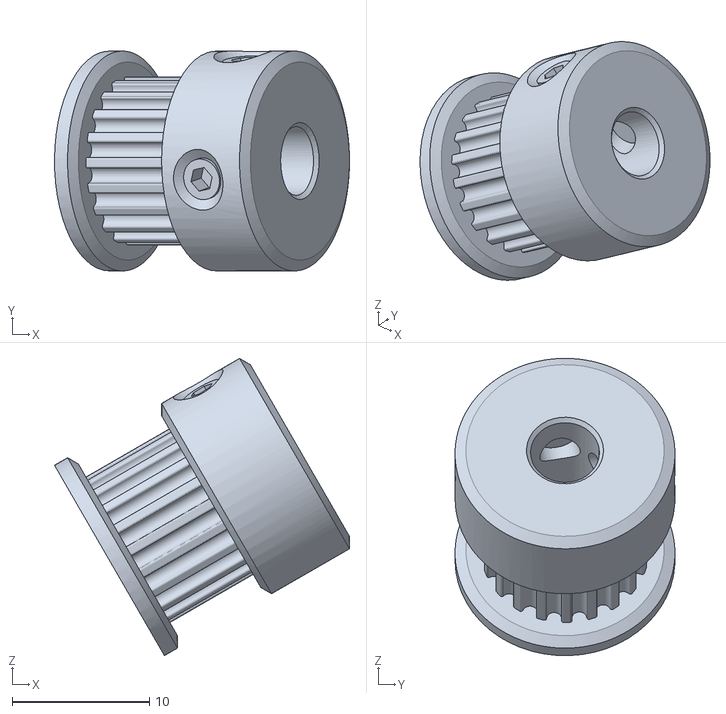
[picture p60: CAD file, 2022-04-01]
Delta-X-Robot/Delta X 1 - GT2_20T_5-6.STL
21.5 x 16.0 x 21.6
