deltaxrobot/Delta-X-3D-Printed-Parts/Delta-X-Robot/Delta X 1 - MovingBase-4 Joint Ball-3.STL

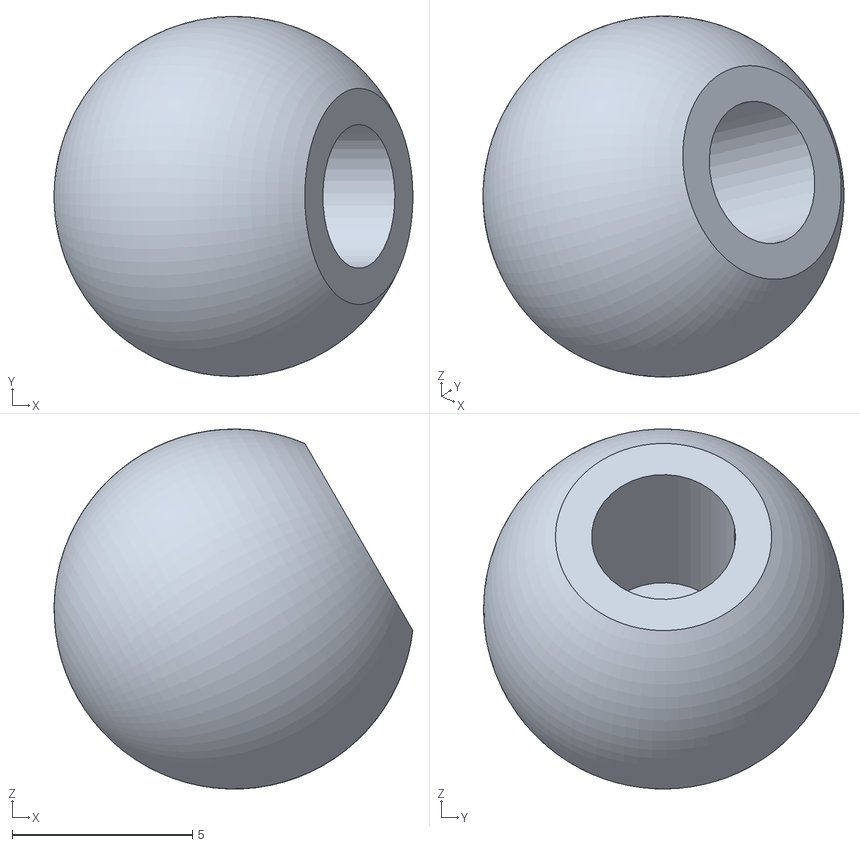
[picture p61: CAD file, 2022-04-01]
Delta-X-Robot/Delta X 1 - MovingBase-4 Joint Ball-3.STL
9.96 x 10.00 x 10.00
