deltaxrobot/Delta-X-3D-Printed-Parts/Delta-X-Robot/Delta X 1 - Outer Arm-6 Shoulder-1.STL

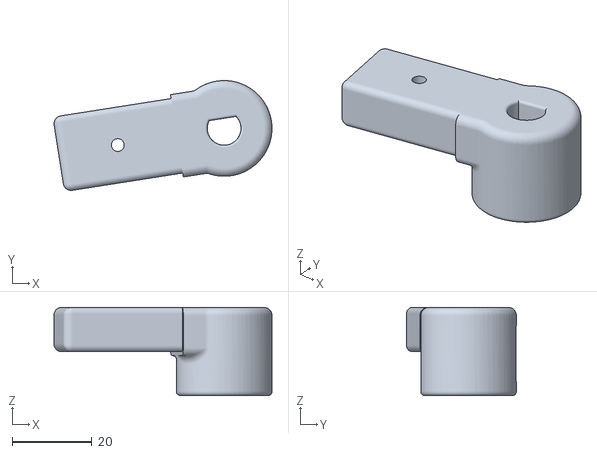
[picture p62: CAD file, 2022-04-01]
Delta-X-Robot/Delta X 1 - Outer Arm-6 Shoulder-1.STL
54.7 x 27.5 x 22.1
