deltaxrobot/Delta-X-3D-Printed-Parts/Delta-X-Robot/Delta X 1 - Outer Arm-5 vongdem3m-2.STL

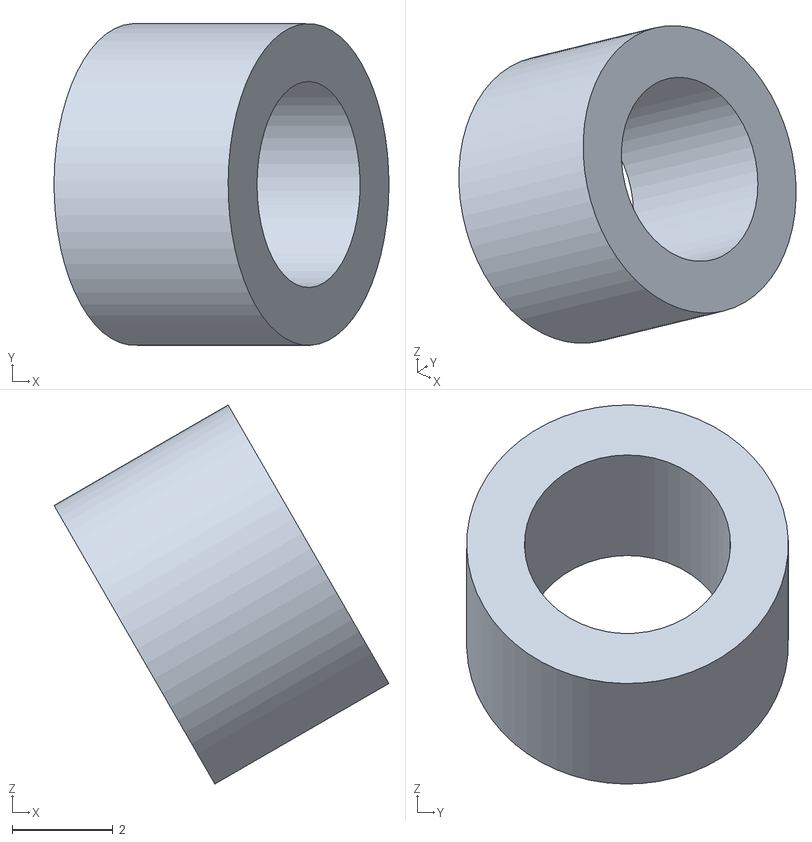
[picture p63: CAD file, 2022-04-01]
Delta-X-Robot/Delta X 1 - Outer Arm-5 vongdem3m-2.STL
6.66 x 6.40 x 7.54
