deltaxrobot/Delta-X-3D-Printed-Parts/Delta-X-Robot/Delta X 1 - Outer Arm-5 Nhomtay-1.STL

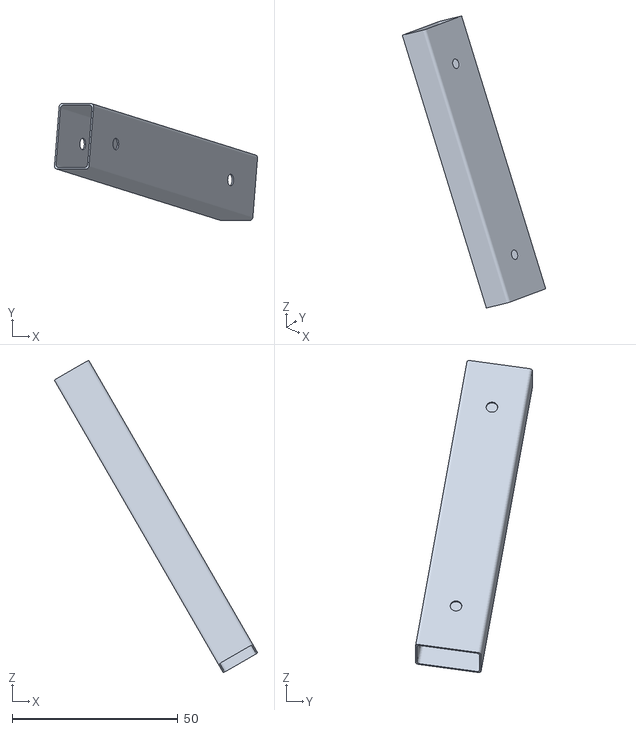
[picture p64: CAD file, 2022-04-01]
Delta-X-Robot/Delta X 1 - Outer Arm-5 Nhomtay-1.STL
61.2 x 35.2 x 94.0
