deltaxrobot/Delta-X-3D-Printed-Parts/Delta-X-Robot/Delta X 1 - ArmSpring-6.STL

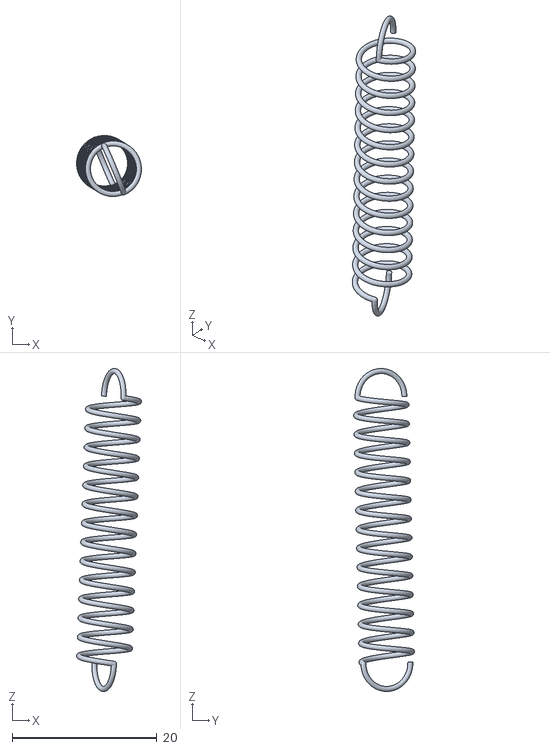
[picture p65: CAD file, 2022-04-01]
Delta-X-Robot/Delta X 1 - ArmSpring-6.STL
8.96 x 8.42 x 44.6
