deltaxrobot/Delta-X-3D-Printed-Parts/Delta-X-Robot/Delta X 1 - Outer Arm-6 vongdem3m-1.STL

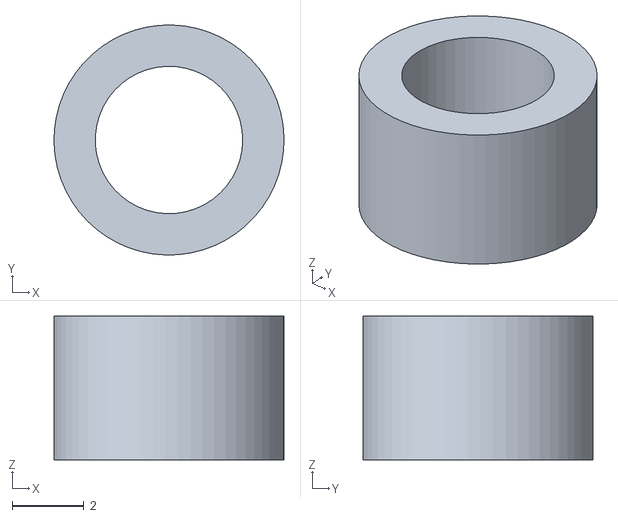
[picture p66: CAD file, 2022-04-01]
Delta-X-Robot/Delta X 1 - Outer Arm-6 vongdem3m-1.STL
6.40 x 6.40 x 4.00
