deltaxrobot/Delta-X-3D-Printed-Parts/Delta-X-Robot/Delta X 1 - Stepper Servo-1.STL

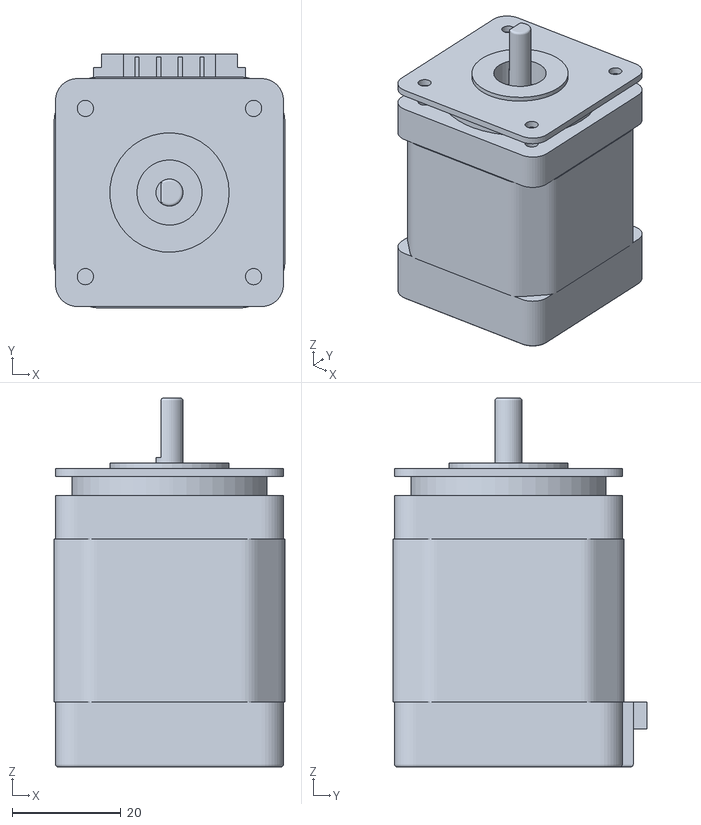
[picture p67: CAD file, 2022-04-01]
Delta-X-Robot/Delta X 1 - Stepper Servo-1.STL
42.5 x 46.8 x 68.0
