deltaxrobot/Delta-X-3D-Printed-Parts/Delta-X-Robot/Delta X 1 - Outer Arm-5 inox8-1.STL

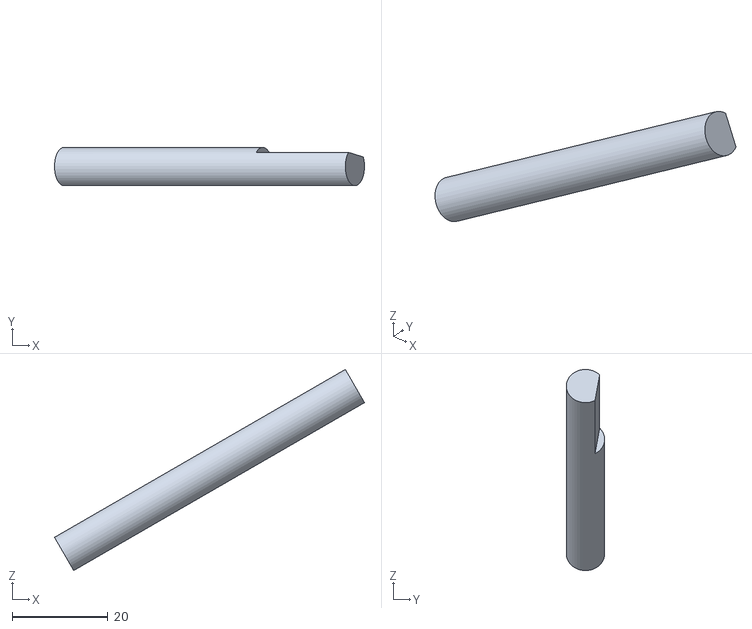
[picture p68: CAD file, 2022-04-01]
Delta-X-Robot/Delta X 1 - Outer Arm-5 inox8-1.STL
64.6 x 7.99 x 41.9
