deltaxrobot/Delta-X-3D-Printed-Parts/Delta-X-Robot/Delta X 1 - Bearing 8_16-3.STL

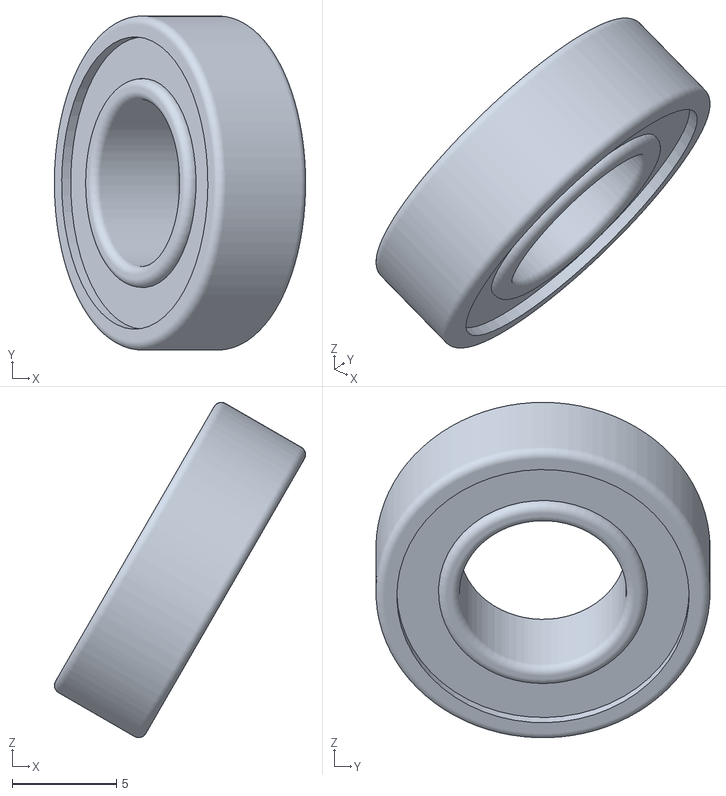
[picture p69: CAD file, 2022-04-01]
Delta-X-Robot/Delta X 1 - Bearing 8_16-3.STL
12.0 x 16.0 x 16.1
