deltaxrobot/Delta-X-3D-Printed-Parts/Delta-X-Robot/Delta X 1 - Outer Arm-6 ring 8mm-1.STL

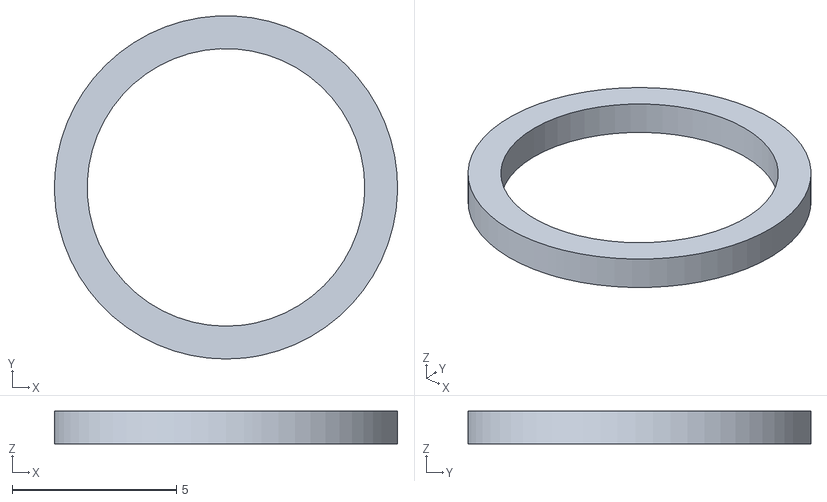
[picture p70: CAD file, 2022-04-01]
Delta-X-Robot/Delta X 1 - Outer Arm-6 ring 8mm-1.STL
10.4 x 10.4 x 1.00
