deltaxrobot/Delta-X-3D-Printed-Parts/Delta-X-Robot/Delta X 1 - OuterArm1-15 RodEnd-1-V2-1.STL

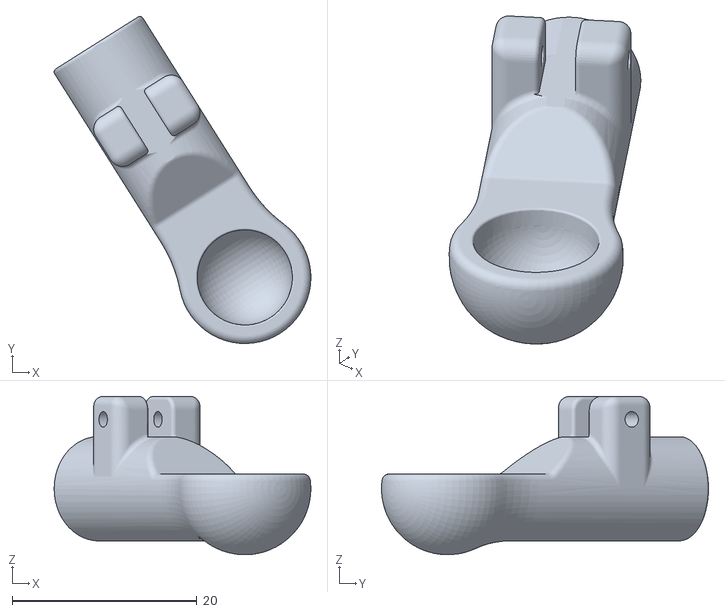
[picture p71: CAD file, 2022-04-01]
Delta-X-Robot/Delta X 1 - OuterArm1-15 RodEnd-1-V2-1.STL
27.8 x 35.4 x 17.1
