deltaxrobot/Delta-X-3D-Printed-Parts/Delta-X-Robot/Delta X 1 - Endstop Limit Switch-2.STL

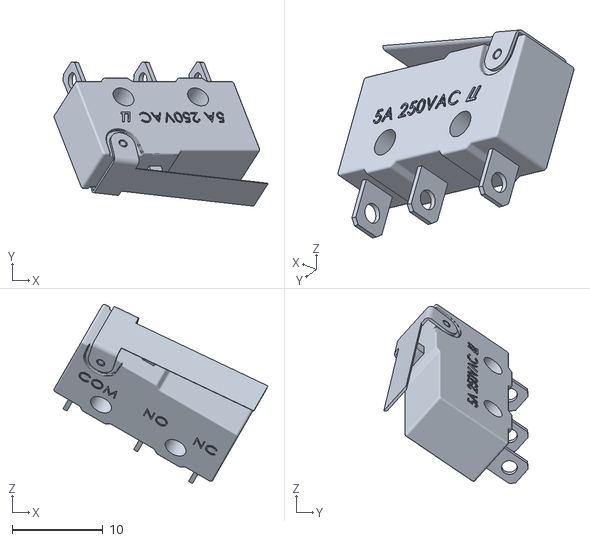
[picture p72: CAD file, 2022-04-01]
Delta-X-Robot/Delta X 1 - Endstop Limit Switch-2.STL
23.6 x 15.9 x 19.8
