deltaxrobot/Delta-X-3D-Printed-Parts/Delta-X-Robot/Delta X 1 - MovingBase-4 M4x60 thread-3.STL

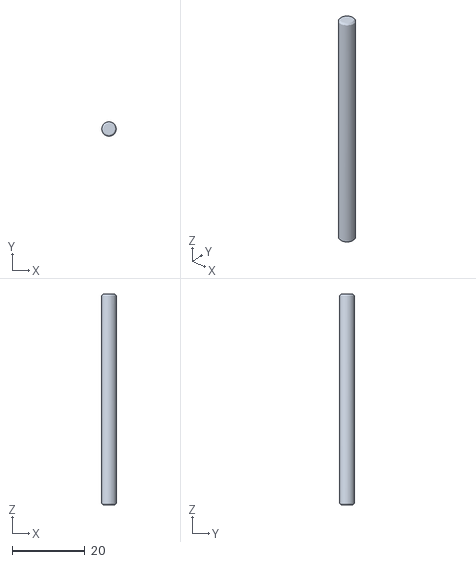
[picture p73: CAD file, 2022-04-01]
Delta-X-Robot/Delta X 1 - MovingBase-4 M4x60 thread-3.STL
4.00 x 4.00 x 58.0
