deltaxrobot/Delta-X-3D-Printed-Parts/Delta-X-Robot/Delta X 1 - GearboxLid V2-2.STL

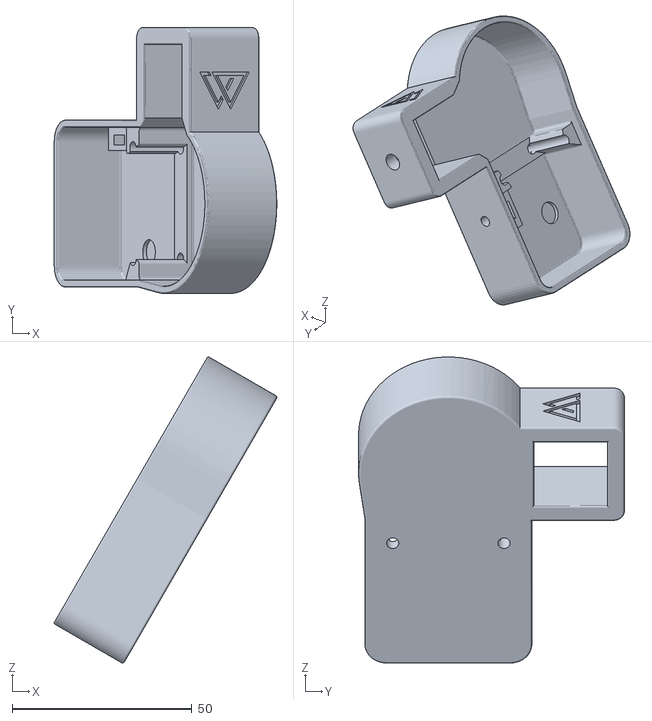
[picture p74: CAD file, 2022-04-01]
Delta-X-Robot/Delta X 1 - GearboxLid V2-2.STL
61.9 x 74.0 x 85.2
