deltaxrobot/Delta-X-3D-Printed-Parts/Delta-X-Robot/Delta X 1 - Outer Arm-6 ElbowV2-1.STL

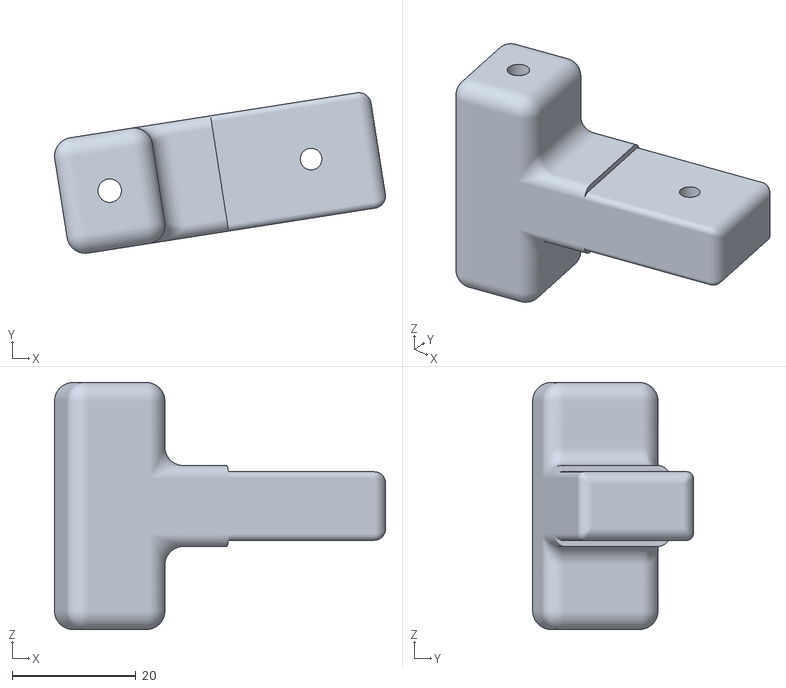
[picture p75: CAD file, 2022-04-01]
Delta-X-Robot/Delta X 1 - Outer Arm-6 ElbowV2-1.STL
53.6 x 26.0 x 40.0
