deltaxrobot/Delta-X-3D-Printed-Parts/Delta-X-Robot/Delta X 1 - Bearing 8_16-2.STL

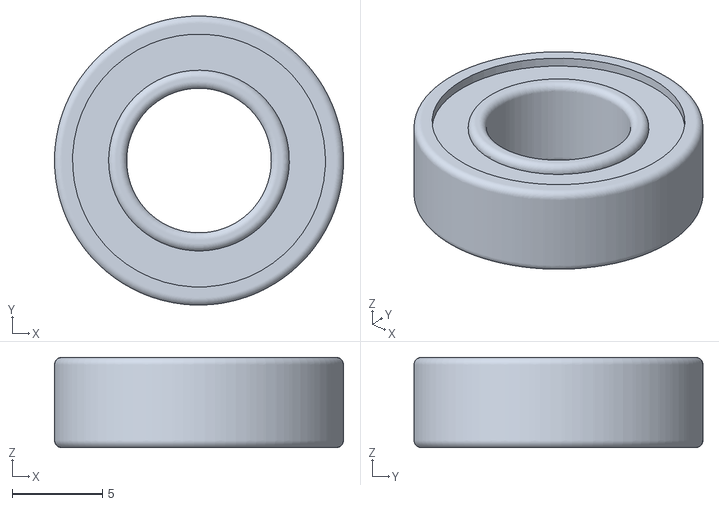
[picture p76: CAD file, 2022-04-01]
Delta-X-Robot/Delta X 1 - Bearing 8_16-2.STL
16.0 x 16.0 x 5.00
