deltaxrobot/Delta-X-3D-Printed-Parts/Delta-X-Robot/Delta X 1 - BeltTensionerBase-v1-3.STL

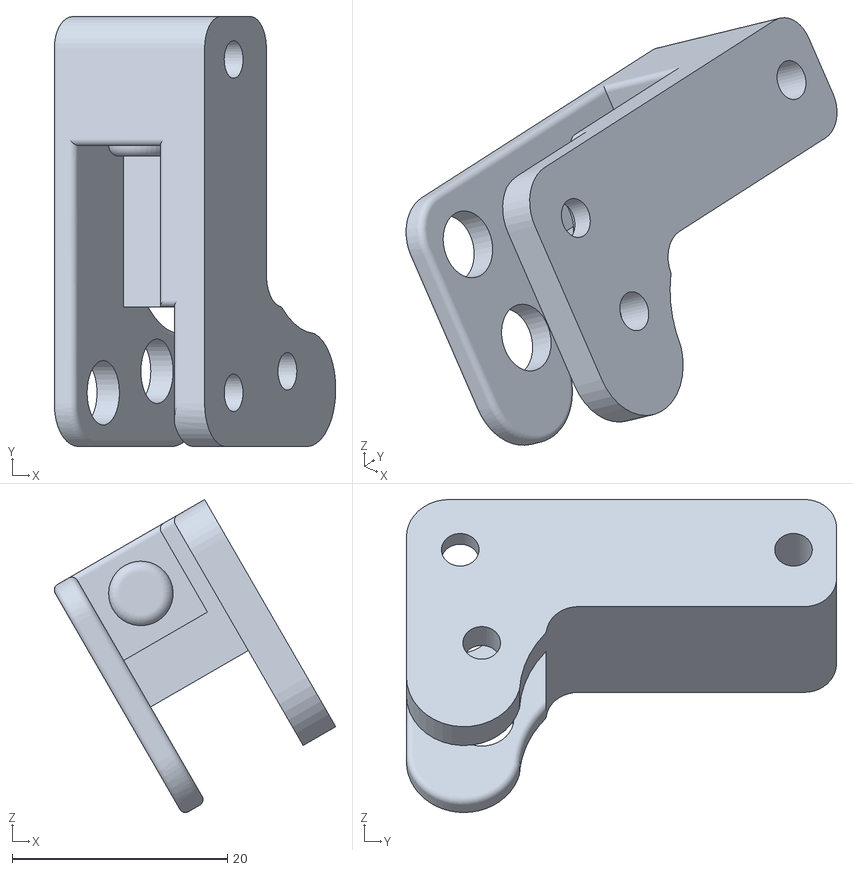
[picture p77: CAD file, 2022-04-01]
Delta-X-Robot/Delta X 1 - BeltTensionerBase-v1-3.STL
26.2 x 40.0 x 29.1
