deltaxrobot/Delta-X-3D-Printed-Parts/Delta-X-Robot/Delta X 1 - Endstop Limit Switch-3.STL

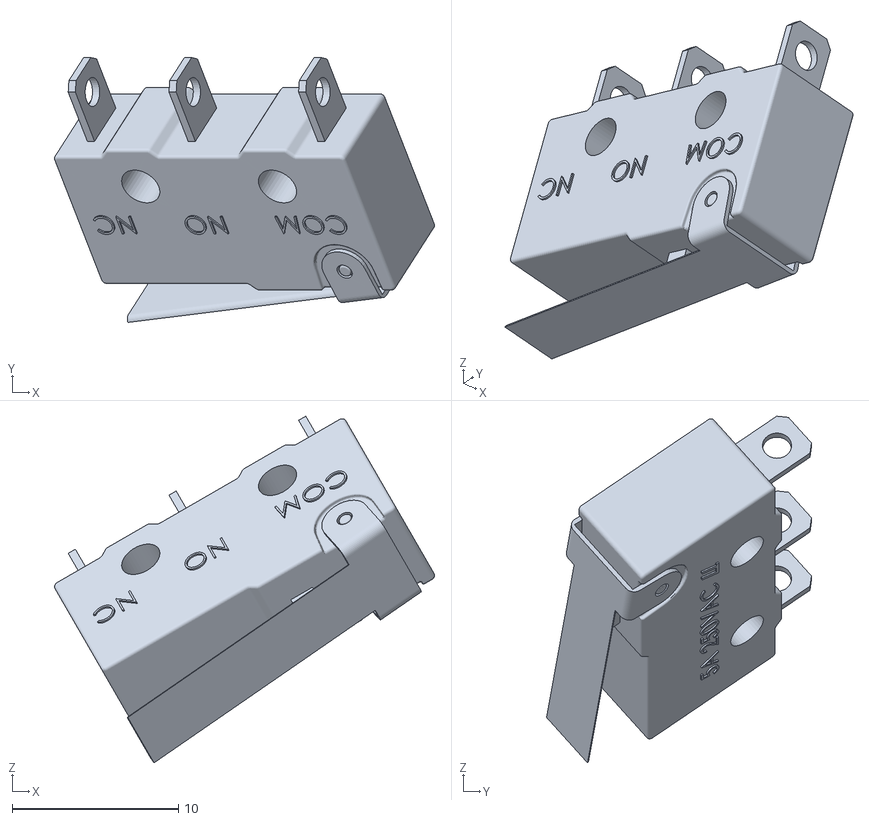
[picture p78: CAD file, 2022-04-01]
Delta-X-Robot/Delta X 1 - Endstop Limit Switch-3.STL
22.9 x 15.9 x 20.8
