deltaxrobot/Delta-X-3D-Printed-Parts/Delta-X-Robot/Delta X 1 - 2020_Alu profile-1.STL

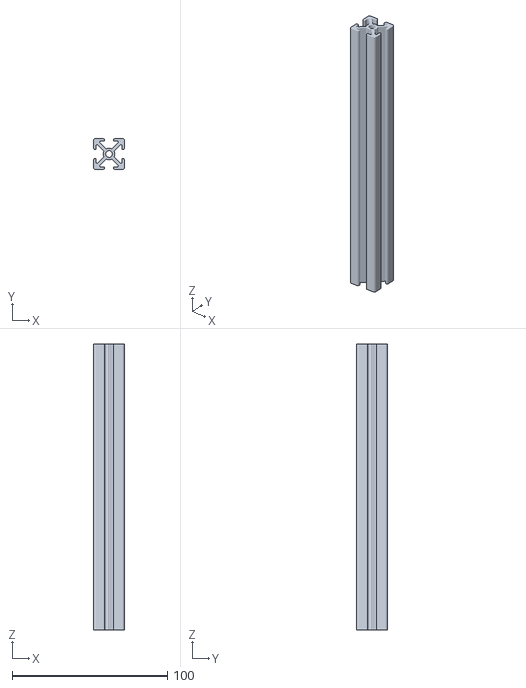
[picture p79: CAD file, 2022-04-01]
Delta-X-Robot/Delta X 1 - 2020_Alu profile-1.STL
20.0 x 20.0 x 184.0
