deltaxrobot/Delta-X-3D-Printed-Parts/Delta-X-Robot/Delta X 1 - Belt1-1^Delta X 1-2.STL

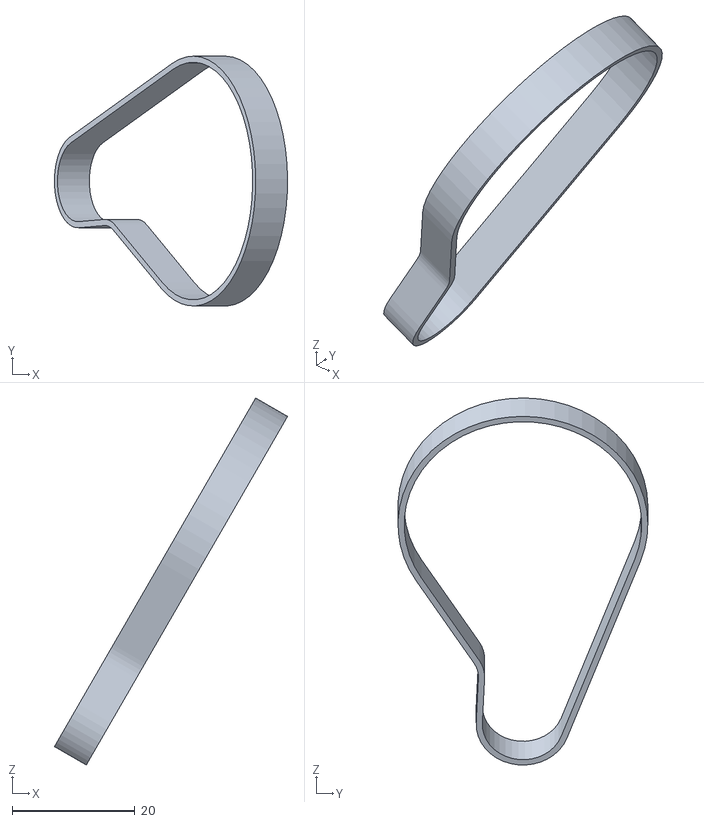
[picture p80: CAD file, 2022-04-01]
Delta-X-Robot/Delta X 1 - Belt1-1^Delta X 1-2.STL
38.0 x 40.7 x 59.8
