deltaxrobot/Delta-X-3D-Printed-Parts/Delta-X-Robot/Delta X 1 - Bearing 5_16-1.STL

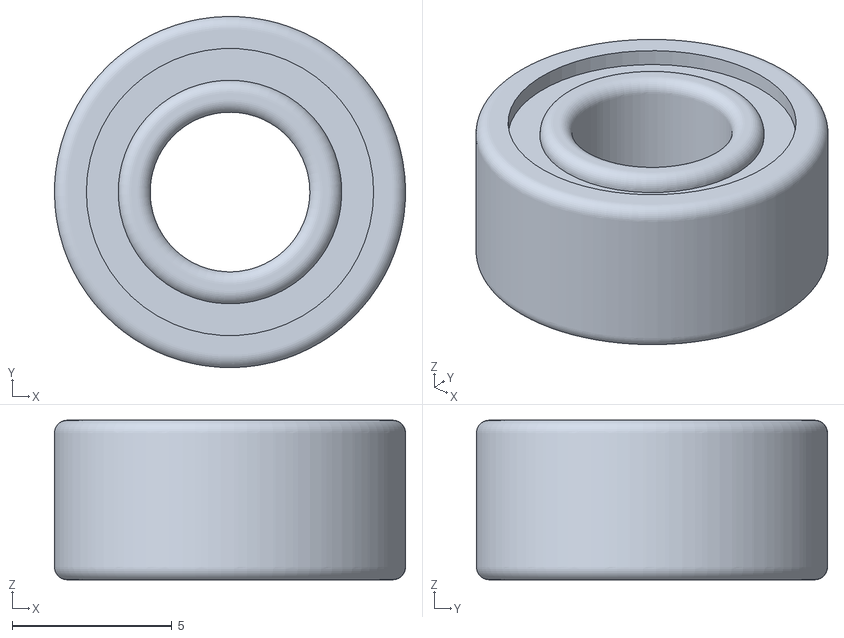
[picture p81: CAD file, 2022-04-01]
Delta-X-Robot/Delta X 1 - Bearing 5_16-1.STL
11.0 x 11.0 x 5.00
