deltaxrobot/Delta-X-3D-Printed-Parts/Delta-X-Robot/Delta X 1 - Stepper Servo-3.STL

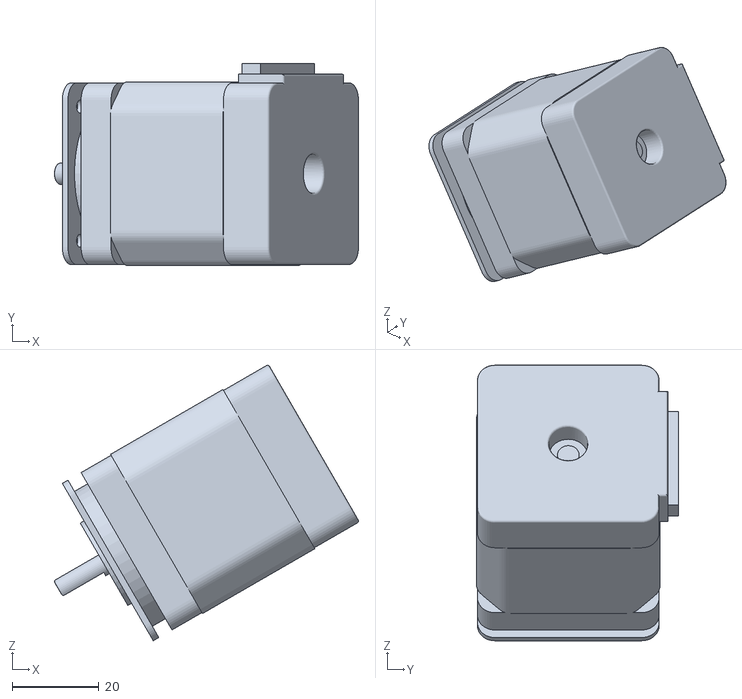
[picture p82: CAD file, 2022-04-01]
Delta-X-Robot/Delta X 1 - Stepper Servo-3.STL
70.3 x 46.8 x 63.7
