deltaxrobot/Delta-X-3D-Printed-Parts/Delta-X-Robot/Delta X 1 - Outer Arm-5 ElbowV2-1.STL

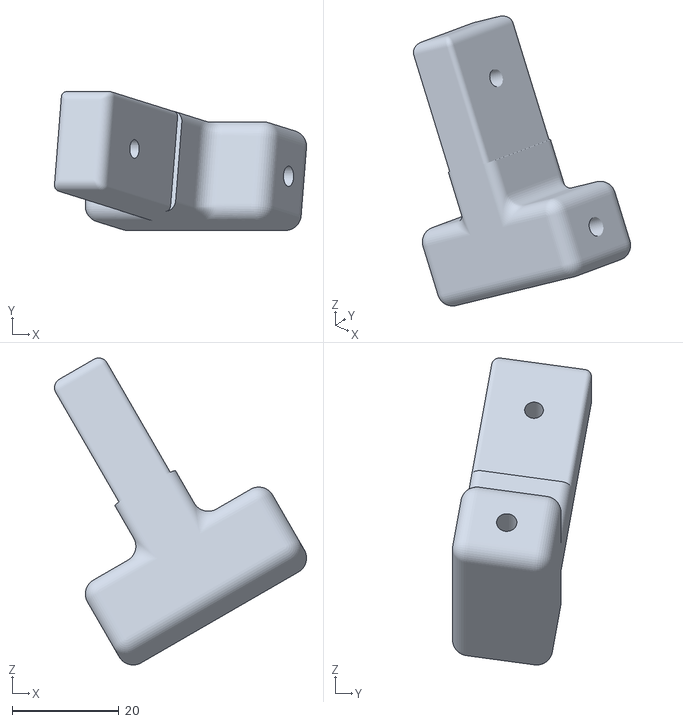
[picture p83: CAD file, 2022-04-01]
Delta-X-Robot/Delta X 1 - Outer Arm-5 ElbowV2-1.STL
47.1 x 26.0 x 57.4
