deltaxrobot/Delta-X-3D-Printed-Parts/Delta-X-Robot/Delta X 1 - Outer Arm-6 inox8-1.STL

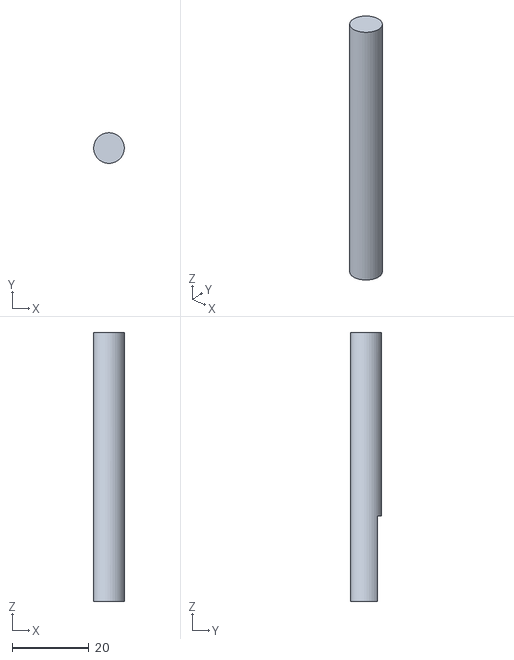
[picture p84: CAD file, 2022-04-01]
Delta-X-Robot/Delta X 1 - Outer Arm-6 inox8-1.STL
7.99 x 7.99 x 70.0
