deltaxrobot/Delta-X-3D-Printed-Parts/Delta-X-Robot/Delta X 1 - Frame connector-1.STL

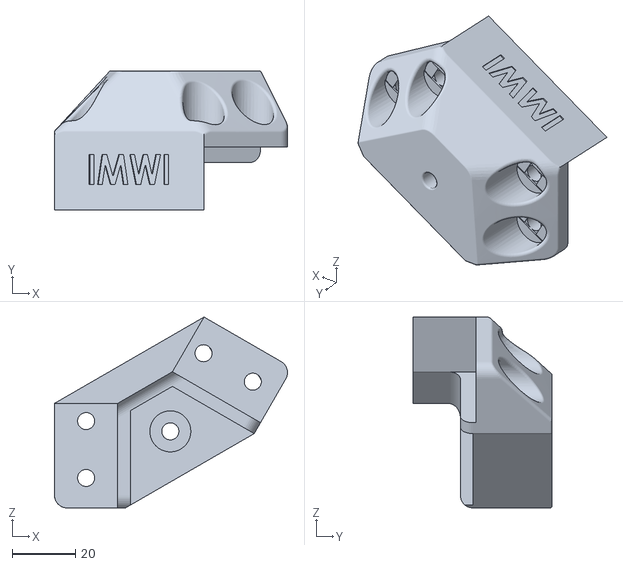
[picture p85: CAD file, 2022-04-01]
Delta-X-Robot/Delta X 1 - Frame connector-1.STL
73.7 x 44.0 x 60.4
