deltaxrobot/Delta-X-3D-Printed-Parts/Delta-X-Robot/Delta X 1 - Outer Arm-2 ring 8mm-1.STL

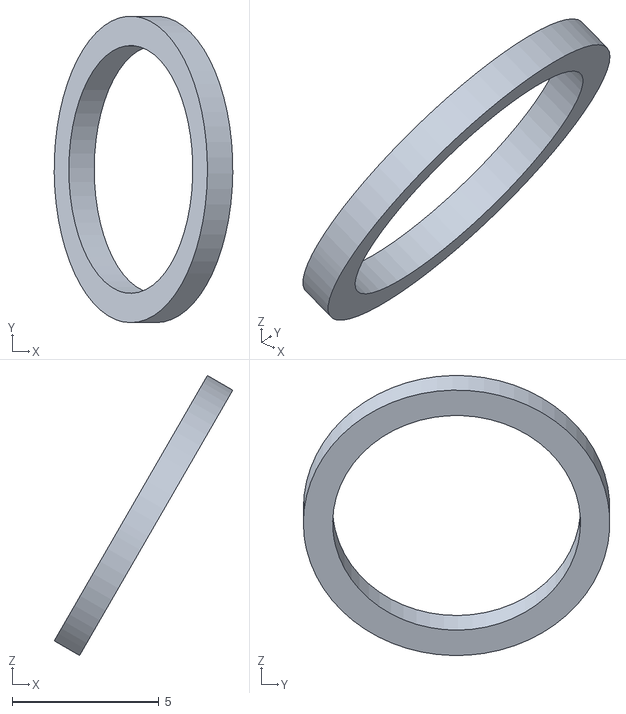
[picture p86: CAD file, 2022-04-01]
Delta-X-Robot/Delta X 1 - Outer Arm-2 ring 8mm-1.STL
6.09 x 10.4 x 9.55
