deltaxrobot/Delta-X-3D-Printed-Parts/Delta-X-Robot/Delta X 1 - 2020_Alu profile-3.STL

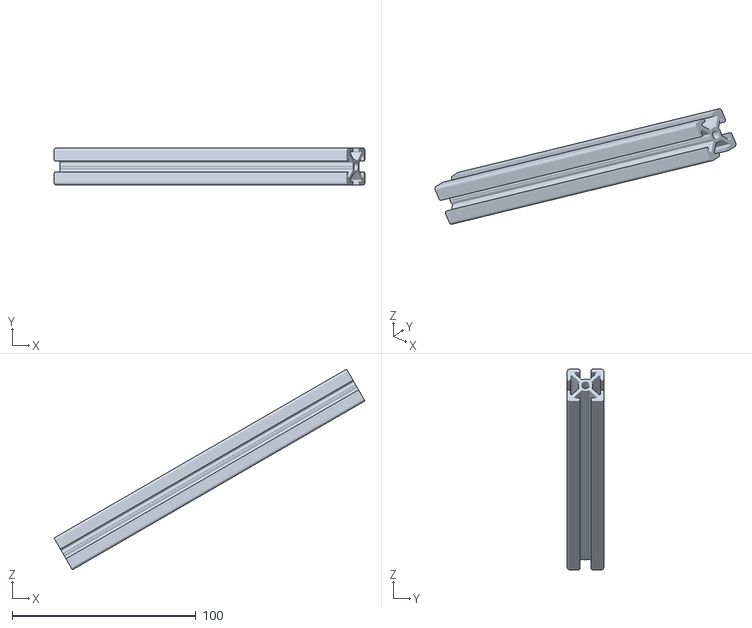
[picture p87: CAD file, 2022-04-01]
Delta-X-Robot/Delta X 1 - 2020_Alu profile-3.STL
169.3 x 20.0 x 109.3
