deltaxrobot/Delta-X-3D-Printed-Parts/Delta-X-Robot/Delta X 1 - EndstopHolder-3.STL

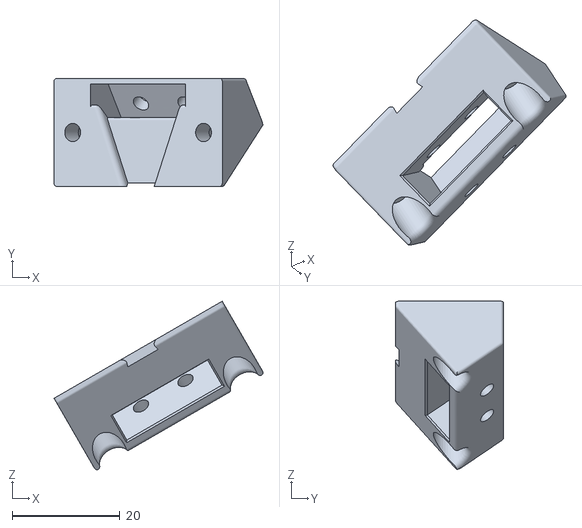
[picture p88: CAD file, 2022-04-01]
Delta-X-Robot/Delta X 1 - EndstopHolder-3.STL
38.7 x 20.0 x 31.2
