deltaxrobot/Delta-X-3D-Printed-Parts/Delta-X-Robot/Delta X 1 - GT2_60T_8-6.STL

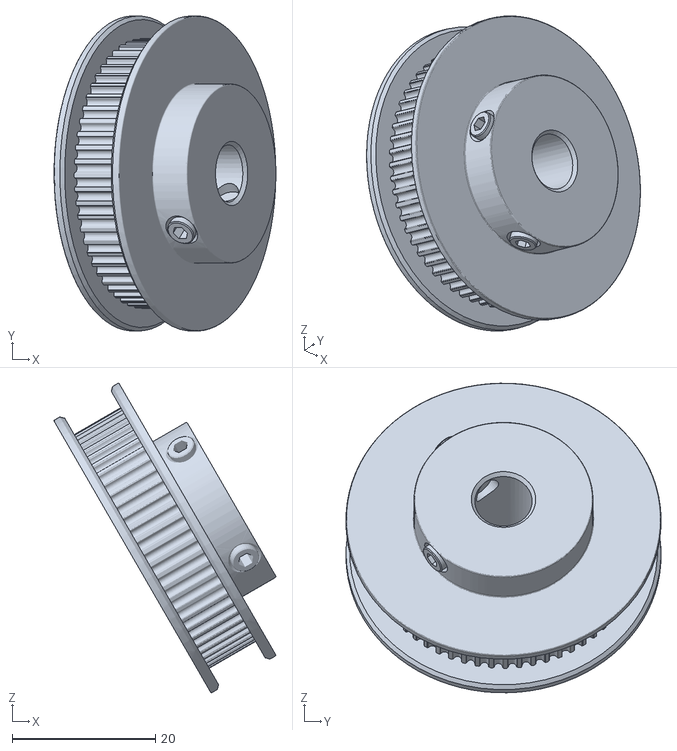
[picture p89: CAD file, 2022-04-01]
Delta-X-Robot/Delta X 1 - GT2_60T_8-6.STL
31.0 x 44.0 x 43.2
