deltaxrobot/Delta-X-3D-Printed-Parts/Delta-X-Robot/Delta X 1 - GearBoxSprings-1.STL

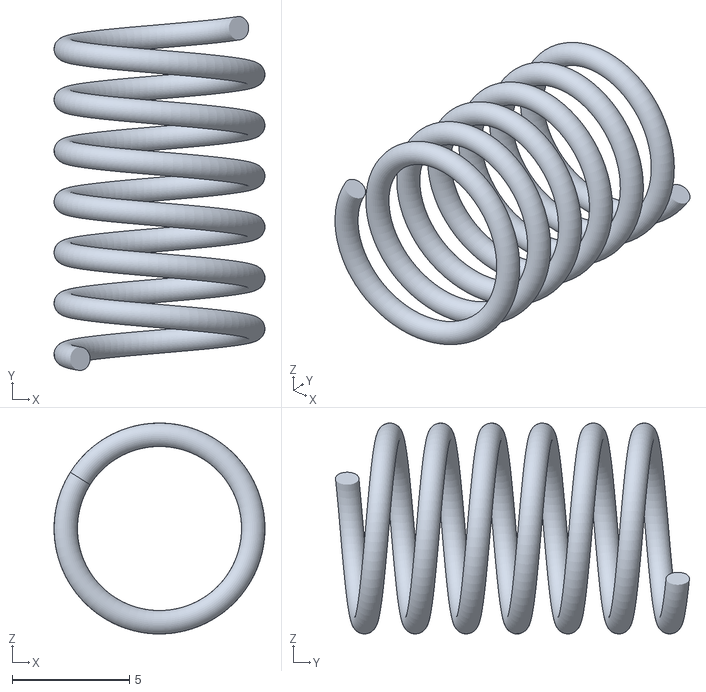
[picture p90: CAD file, 2022-04-01]
Delta-X-Robot/Delta X 1 - GearBoxSprings-1.STL
9.00 x 15.1 x 9.00
