deltaxrobot/Delta-X-3D-Printed-Parts/Delta-X-Robot/Delta X 1 - ArmSpring-1.STL

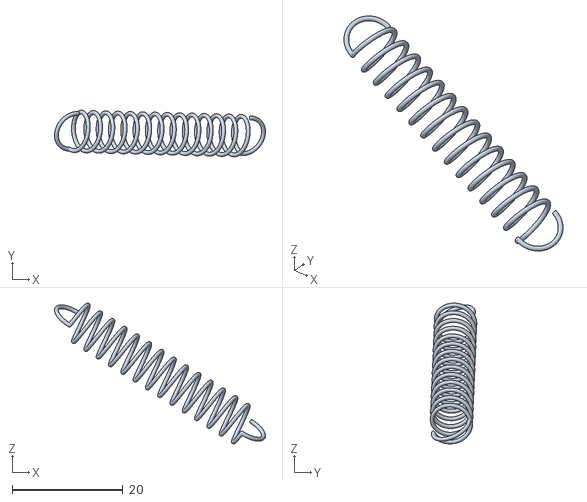
[picture p91: CAD file, 2022-04-01]
Delta-X-Robot/Delta X 1 - ArmSpring-1.STL
38.1 x 8.42 x 25.4
