deltaxrobot/Delta-X-3D-Printed-Parts/Delta-X-Robot/Delta X 1 - OuterArm1-15 cacbon-1.STL

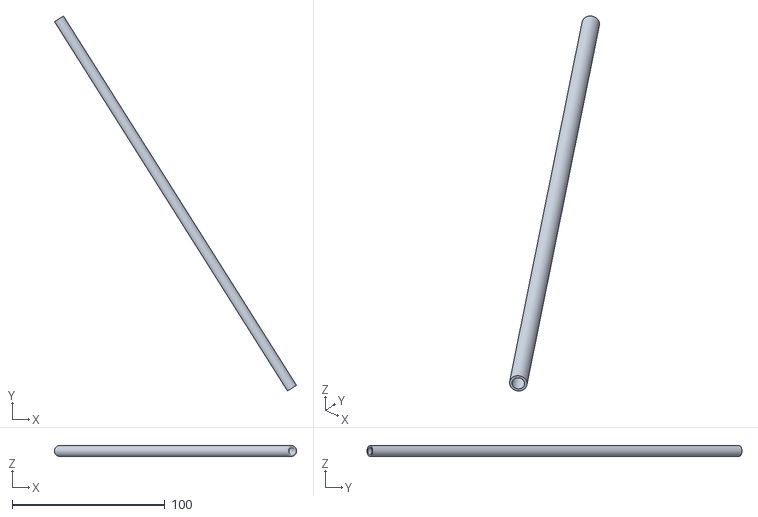
[picture p92: CAD file, 2022-04-01]
Delta-X-Robot/Delta X 1 - OuterArm1-15 cacbon-1.STL
158.5 x 245.6 x 7.00
