deltaxrobot/Delta-X-3D-Printed-Parts/Delta-X-Robot/Delta X 1 - Alu plate increase hardness-1.STL

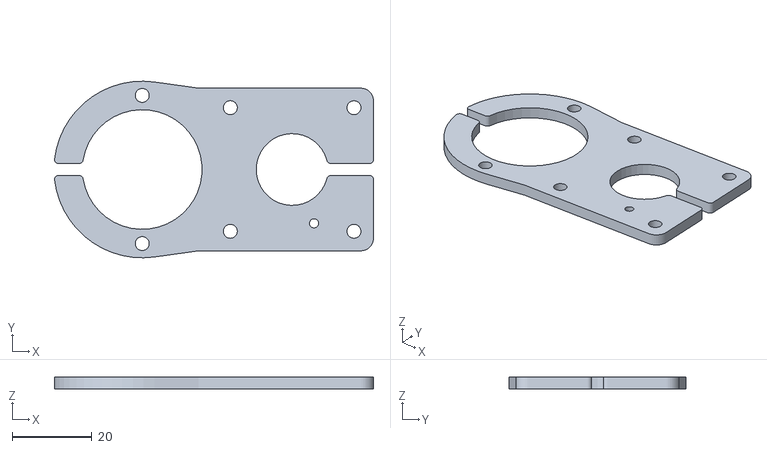
[picture p93: CAD file, 2022-04-01]
Delta-X-Robot/Delta X 1 - Alu plate increase hardness-1.STL
80.0 x 44.3 x 3.00
