deltaxrobot/Delta-X-3D-Printed-Parts/Delta-X-Robot/Delta X 1 - Endstop Limit Switch-1.STL

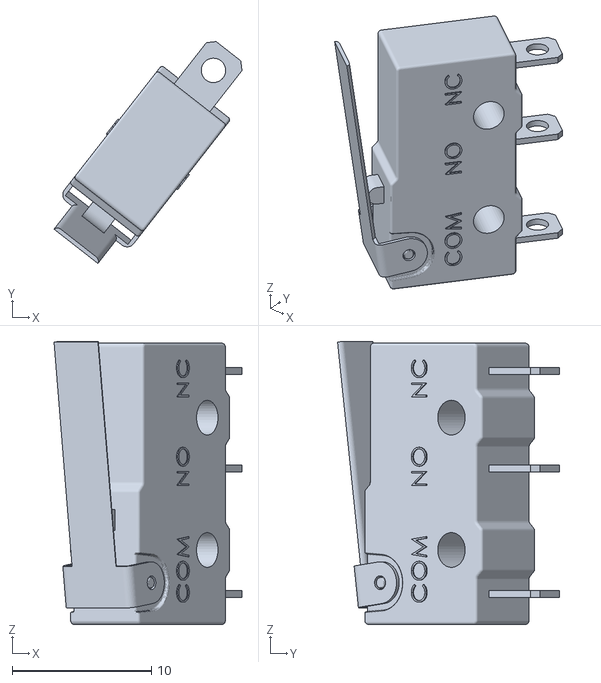
[picture p94: CAD file, 2022-04-01]
Delta-X-Robot/Delta X 1 - Endstop Limit Switch-1.STL
13.5 x 15.9 x 20.3
