deltaxrobot/Delta-X-3D-Printed-Parts/Delta-X-Robot/Delta X 1 - Alu plate increase hardness-2.STL

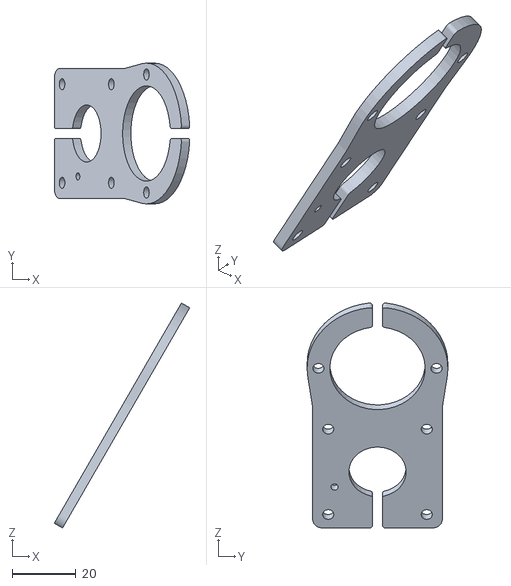
[picture p95: CAD file, 2022-04-01]
Delta-X-Robot/Delta X 1 - Alu plate increase hardness-2.STL
42.6 x 44.3 x 70.8
