deltaxrobot/Delta-X-3D-Printed-Parts/Delta-X-Robot/Delta X 1 - Frame connector-4.STL

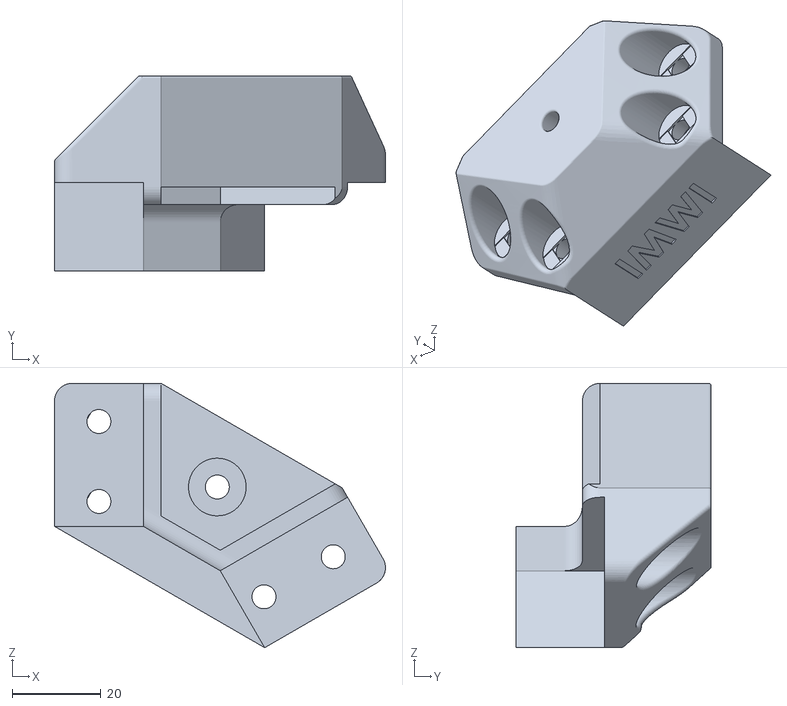
[picture p96: CAD file, 2022-04-01]
Delta-X-Robot/Delta X 1 - Frame connector-4.STL
74.5 x 44.0 x 59.5
