deltaxrobot/Delta-X-3D-Printed-Parts/Delta-X-Robot/Delta X 1 - Frame connector-3.STL

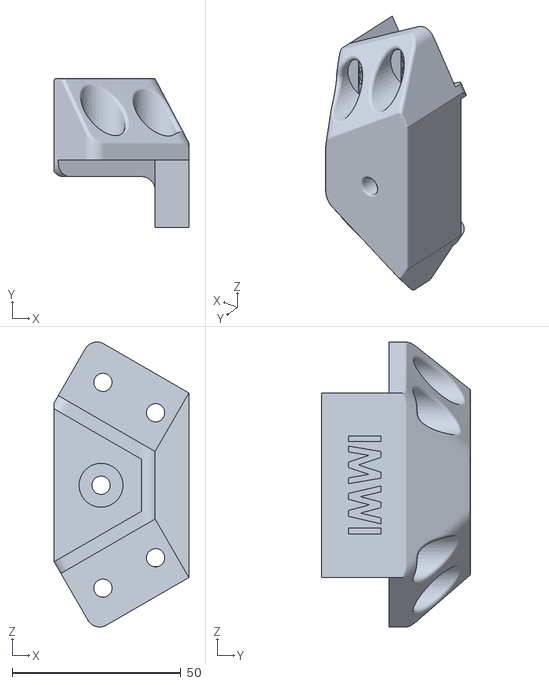
[picture p97: CAD file, 2022-04-01]
Delta-X-Robot/Delta X 1 - Frame connector-3.STL
39.9 x 44.0 x 84.4
