deltaxrobot/Delta-X-3D-Printed-Parts/Delta-X-Robot/Delta X 1 - GearboxBody V2-2.STL

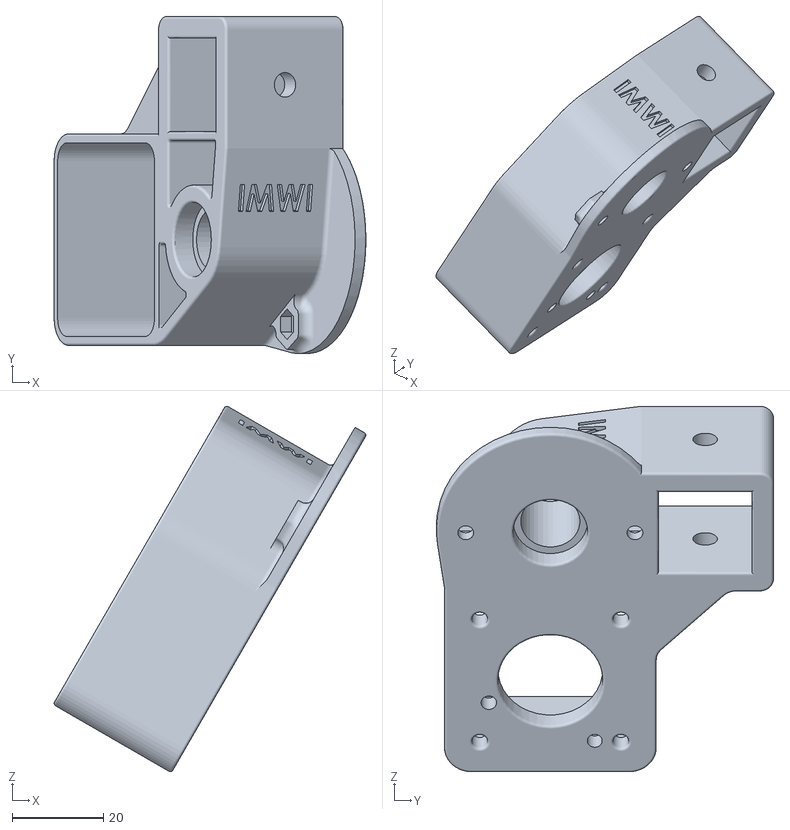
[picture p98: CAD file, 2022-04-01]
Delta-X-Robot/Delta X 1 - GearboxBody V2-2.STL
68.5 x 74.0 x 80.2
