deltaxrobot/Delta-X-3D-Printed-Parts/Delta-X-Robot/Delta X 1 - EndstopHolder-1.STL

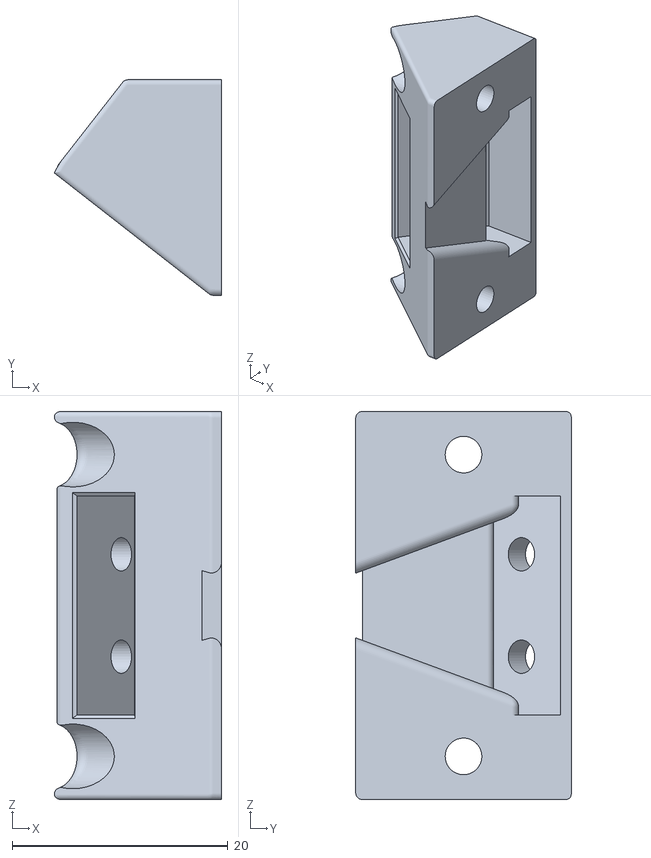
[picture p99: CAD file, 2022-04-01]
Delta-X-Robot/Delta X 1 - EndstopHolder-1.STL
15.5 x 20.0 x 36.0
