deltaxrobot/Delta-X-3D-Printed-Parts/Delta-X-Robot/Delta X 1 - Outer Arm-6 Nhomtay-1.STL

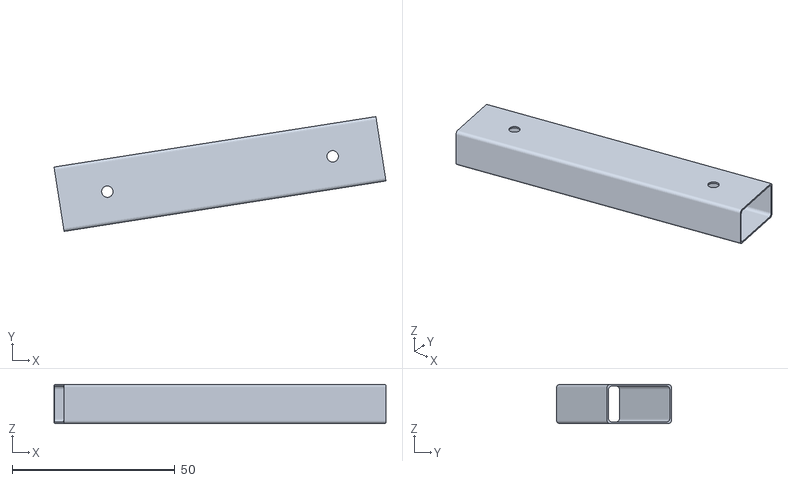
[picture p101: CAD file, 2022-04-01]
Delta-X-Robot/Delta X 1 - Outer Arm-6 Nhomtay-1.STL
101.9 x 35.2 x 12.0
