deltaxrobot/Delta-X-3D-Printed-Parts/Delta-X-Robot/Delta X 1 - Bearing 5_16-2.STL

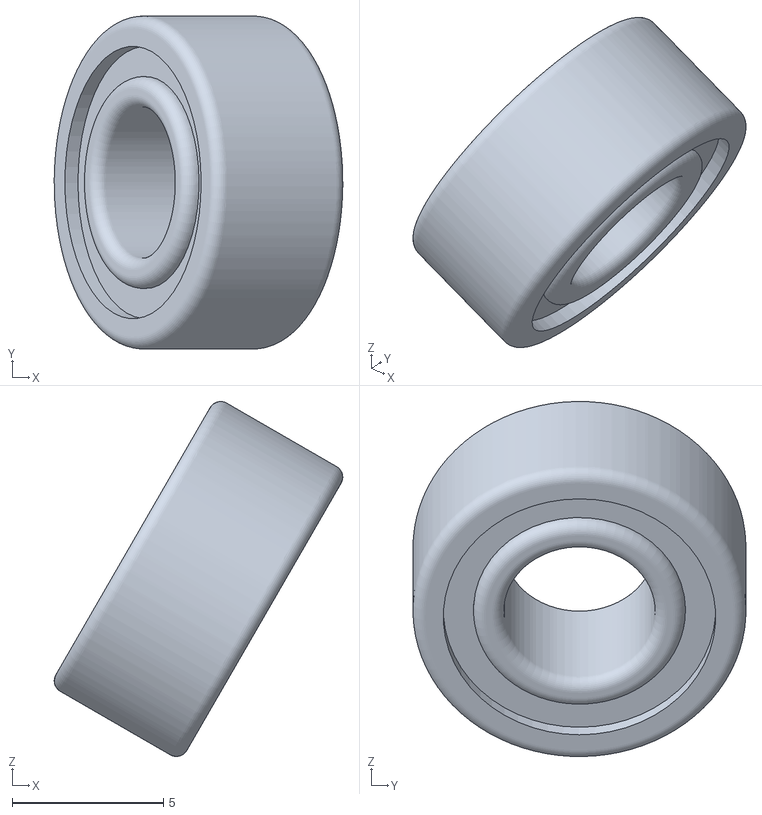
[picture p102: CAD file, 2022-04-01]
Delta-X-Robot/Delta X 1 - Bearing 5_16-2.STL
9.53 x 11.0 x 11.7
