deltaxrobot/Delta-X-3D-Printed-Parts/(list of files, cad)

Other CAD files:
Conveyor-X/RollerAxisHolder.STL
Slider-X/WheelHolder-3.STL
Delta-X-Robot/Delta X 1 - MovingBase-4 Joint Ball-1.STL
Delta-X-Robot/Delta X 1 - BeltTensioner-3.STL
Delta-X-Robot/Delta X 1 - MovingBase-4 Joint Ball-2.STL
Delta-X-Robot/Delta X 1 - Outer Arm-5 M4x60 thread-1.STL
Delta-X-Robot/Delta X 1 - Outer Arm-5 vongdem3m-1.STL
Delta-X-Robot/Delta X 1 - OuterArm1-19 RodEnd-1-V2-1.STL
Delta-X-Robot/Delta X 1 - Outer Arm-2 inox8-1.STL
Delta-X-Robot/Delta X 1 - OuterArm1-14 RodEnd-1-V2-1.STL
Delta-X-Robot/Delta X 1 - Outer Arm-2 Nhomtay-1.STL
Delta-X-Robot/Delta X 1 - MovingBase-4 Joint Ball-6.STL
Delta-X-Robot/Delta X 1 - Outer Arm-2 vongdem3m-1.STL
Delta-X-Robot/Delta X 1 - GT2_20T_5-5.STL
Delta-X-Robot/Delta X 1 - MovingBase-4 vongdem3m-4.STL
Delta-X-Robot/Delta X 1 - OuterArm1-17 Spring Stick-2.STL
Delta-X-Robot/Delta X 1 - Outer Arm-2 Joint Ball-1.STL
Delta-X-Robot/Delta X 1 - Outer Arm-6 Joint Ball-1.STL
Delta-X-Robot/Delta X 1 - OuterArm1-16 cacbon-1.STL
Delta-X-Robot/Delta X 1 - OuterArm1-16 Spring Stick-1.STL
Delta-X-Robot/Delta X 1 - OuterArm1-15 RodEnd-1-V2-2.STL
Delta-X-Robot/Delta X 1 - OuterArm1-19 Spring Stick-1.STL
Delta-X-Robot/Delta X 1 - ring 8mm-1.STL
Delta-X-Robot/Delta X 1 - OuterArm1-18 cacbon-1.STL
Delta-X-Robot/Delta X 1 - OuterArm1-17 cacbon-1.STL
Delta-X-Robot/Delta X 1 - Outer Arm-6 M4x60 thread-1.STL
Delta-X-Robot/Delta X 1 - OuterArm1-18 Spring Stick-2.STL
Delta-X-Robot/Delta X 1 - Outer Arm-5 Joint Ball-2.STL
Delta-X-Robot/Delta X 1 - BeltTensioner-2.STL
Delta-X-Robot/Delta X 1 - ring 8mm-3.STL
Delta-X-Robot/Delta X 1 - OuterArm1-16 RodEnd-1-V2-2.STL
Delta-X-Robot/Delta X 1 - MovingBase-4 vongdem3m-6.STL
Delta-X-Robot/Delta X 1 - BeltTensioner-1.STL
Delta-X-Robot/Delta X 1 - Outer Arm-2 M4x60 thread-1.STL
Delta-X-Robot/Delta X 1 - OuterArm1-17 RodEnd-1-V2-2.STL
Delta-X-Robot/Delta X 1 - MovingBase-4 vongdem3m-2.STL
Delta-X-Robot/Delta X 1 - OuterArm1-15 Spring Stick-1.STL
Delta-X-Robot/Delta X 1 - OuterArm1-17 Spring Stick-1.STL
Delta-X-Robot/Delta X 1 - Outer Arm-5 Joint Ball-1.STL
Delta-X-Robot/Delta X 1 - OuterArm1-14 RodEnd-1-V2-2.STL
Delta-X-Robot/Delta X 1 - 2020_Alu profile-2.STL
Delta-X-Robot/Delta X 1 - Outer Arm-2 vongdem3m-2.STL
Delta-X-Robot/Delta X 1 - GearBoxSprings-3.STL
Delta-X-Robot/Delta X 1 - Bearing 8_16-6.STL
Delta-X-Robot/Delta X 1 - ArmSpring-4.STL
Delta-X-Robot/Delta X 1 - Bearing 8_16-5.STL
Delta-X-Robot/Delta X 1 - OuterArm1-18 RodEnd-1-V2-1.STL
Delta-X-Robot/Delta X 1 - ArmSpring-3.STL
Delta-X-End-Effectors/Axis4 - Gripper/v2/Base2.stl
Delta-X-End-Effectors/Vacuum/VaccumBox.STL
Delta-X-Robot/Delta X 1 - Alu plate increase hardness-3.STL
Delta-X-Robot/Delta X 1 - ArmSpring-2.STL
Delta-X-Robot/Delta X 1 - Bearing 5_16-3.STL
Delta-X-Robot/Delta X 1 - Bearing 8_16-1.STL
Delta-X-Robot/Delta X 1 - Bearing 8_16-4.STL
Delta-X-Robot/Delta X 1 - Belt1-1^Delta X 1-1.STL
Delta-X-Robot/Delta X 1 - Belt1-1^Delta X 1-3.STL
Delta-X-Robot/Delta X 1 - BeltTensionerBase-v1-1.STL
Delta-X-Robot/Delta X 1 - BeltTensionerBase-v1-2.STL
Delta-X-Robot/Delta X 1 - Cross M3x10 bolt-1.STL
Delta-X-Robot/Delta X 1 - Cross M3x10 bolt-2.STL
Delta-X-Robot/Delta X 1 - Cross M3x10 bolt-3.STL
Delta-X-Robot/Delta X 1 - Cross M3x10 bolt-4.STL
Delta-X-Robot/Delta X 1 - Cross M3x10 bolt-5.STL
Delta-X-Robot/Delta X 1 - Cross M3x10 bolt-6.STL
Delta-X-Robot/Delta X 1 - Cross M3x16 bolt-1.STL
Delta-X-Robot/Delta X 1 - Cross M3x16 bolt-2.STL
Delta-X-Robot/Delta X 1 - Cross M3x16 bolt-3.STL
Delta-X-Robot/Delta X 1 - EndstopHolder-2.STL
Delta-X-Robot/Delta X 1 - GT2_20T_5-4.STL
Delta-X-Robot/Delta X 1 - GT2_60T_8-5.STL
Delta-X-Robot/Delta X 1 - GearBoxSprings-2.STL
Delta-X-Robot/Delta X 1 - GearboxBody V2-1.STL
Delta-X-Robot/Delta X 1 - GearboxBody V2-3.STL
Delta-X-Robot/Delta X 1 - GearboxLid V2-1.STL
Delta-X-Robot/Delta X 1 - GearboxLid V2-3.STL
Delta-X-Robot/Delta X 1 - M3 Nut-1.STL
Delta-X-Robot/Delta X 1 - M3 Nut-10.STL
Delta-X-Robot/Delta X 1 - M3 Nut-11.STL
Delta-X-Robot/Delta X 1 - M3 Nut-12.STL
Delta-X-Robot/Delta X 1 - M3 Nut-13.STL
Delta-X-Robot/Delta X 1 - M3 Nut-14.STL
Delta-X-Robot/Delta X 1 - M3 Nut-15.STL
Delta-X-Robot/Delta X 1 - M3 Nut-2.STL
Delta-X-Robot/Delta X 1 - M3 Nut-3.STL
Delta-X-Robot/Delta X 1 - M3 Nut-4.STL
Delta-X-Robot/Delta X 1 - M3 Nut-5.STL
Delta-X-Robot/Delta X 1 - M3 Nut-6.STL
Delta-X-Robot/Delta X 1 - M3 Nut-7.STL
Delta-X-Robot/Delta X 1 - M3 Nut-8.STL
Delta-X-Robot/Delta X 1 - M3 Nut-9.STL
Delta-X-Robot/Delta X 1 - M3 T Slot Nut-1.STL
Delta-X-Robot/Delta X 1 - M3 T Slot Nut-2.STL
Delta-X-Robot/Delta X 1 - M3 T Slot Nut-3.STL
Delta-X-Robot/Delta X 1 - M3 T Slot Nut-4.STL
Delta-X-Robot/Delta X 1 - M3 T Slot Nut-5.STL
Delta-X-Robot/Delta X 1 - M3 T Slot Nut-6.STL
Delta-X-Robot/Delta X 1 - M3x10 bolt-1.STL
Delta-X-Robot/Delta X 1 - M3x10 bolt-2.STL
Delta-X-Robot/Delta X 1 - M3x10 bolt-3.STL
Delta-X-Robot/Delta X 1 - M3x10 bolt-4.STL
Delta-X-Robot/Delta X 1 - M3x10 bolt-5.STL
Delta-X-Robot/Delta X 1 - M3x10 bolt-6.STL
Delta-X-Robot/Delta X 1 - M3x10 bolt-7.STL
Delta-X-Robot/Delta X 1 - M3x10 bolt-8.STL
Delta-X-Robot/Delta X 1 - M3x10 bolt-9.STL
Delta-X-Robot/Delta X 1 - M3x12 bolt-1.STL
Delta-X-Robot/Delta X 1 - M3x12 bolt-2.STL
Delta-X-Robot/Delta X 1 - M3x12 bolt-3.STL
Delta-X-Robot/Delta X 1 - M3x20 bolt-1.STL
Delta-X-Robot/Delta X 1 - M3x20 bolt-2.STL
Delta-X-Robot/Delta X 1 - M3x20 bolt-3.STL
Delta-X-Robot/Delta X 1 - M3x25 bolt-1.STL
Delta-X-Robot/Delta X 1 - M3x25 bolt-3.STL
Delta-X-Robot/Delta X 1 - M3x25 bolt-4.STL
Delta-X-Robot/Delta X 1 - M3x30 bolt-1.STL
Delta-X-Robot/Delta X 1 - M3x30 bolt-2.STL
Delta-X-Robot/Delta X 1 - M3x30 bolt-3.STL
Delta-X-Robot/Delta X 1 - M3x30 bolt-4.STL
Delta-X-Robot/Delta X 1 - M3x30 bolt-5.STL
Delta-X-Robot/Delta X 1 - M3x30 bolt-6.STL
Delta-X-Robot/Delta X 1 - M3x40 bolt-1.STL
Delta-X-Robot/Delta X 1 - M3x40 bolt-2.STL
Delta-X-Robot/Delta X 1 - M3x40 bolt-3.STL
Delta-X-Robot/Delta X 1 - M5 Washer-1.STL
Delta-X-Robot/Delta X 1 - M5 Washer-10.STL
Delta-X-Robot/Delta X 1 - M5 Washer-11.STL
Delta-X-Robot/Delta X 1 - M5 Washer-12.STL
Delta-X-Robot/Delta X 1 - M5 Washer-13.STL
Delta-X-Robot/Delta X 1 - M5 Washer-14.STL
Delta-X-Robot/Delta X 1 - M5 Washer-15.STL
Delta-X-Robot/Delta X 1 - M5 Washer-16.STL
Delta-X-Robot/Delta X 1 - M5 Washer-17.STL
Delta-X-Robot/Delta X 1 - M5 Washer-18.STL
Delta-X-Robot/Delta X 1 - M5 Washer-19.STL
Delta-X-Robot/Delta X 1 - M5 Washer-2.STL
Delta-X-Robot/Delta X 1 - M5 Washer-20.STL
Delta-X-Robot/Delta X 1 - M5 Washer-21.STL
Delta-X-Robot/Delta X 1 - M5 Washer-22.STL
Delta-X-Robot/Delta X 1 - M5 Washer-3.STL
Delta-X-Robot/Delta X 1 - M5 Washer-4.STL
Delta-X-Robot/Delta X 1 - M5 Washer-6.STL
Delta-X-Robot/Delta X 1 - M5 Washer-7.STL
Delta-X-Robot/Delta X 1 - M5 Washer-8.STL
Delta-X-Robot/Delta X 1 - M5 Washer-9.STL
Delta-X-Robot/Delta X 1 - M5x10 bolt-10.STL
Delta-X-Robot/Delta X 1 - M5x10 bolt-11.STL
Delta-X-Robot/Delta X 1 - M5x10 bolt-12.STL
Delta-X-Robot/Delta X 1 - M5x10 bolt-13.STL
Delta-X-Robot/Delta X 1 - M5x10 bolt-14.STL
Delta-X-Robot/Delta X 1 - M5x10 bolt-15.STL
Delta-X-Robot/Delta X 1 - M5x10 bolt-16.STL
Delta-X-Robot/Delta X 1 - M5x10 bolt-17.STL
Delta-X-Robot/Delta X 1 - M5x10 bolt-18.STL
Delta-X-Robot/Delta X 1 - M5x10 bolt-19.STL
Delta-X-Robot/Delta X 1 - M5x10 bolt-2.STL
Delta-X-Robot/Delta X 1 - M5x10 bolt-20.STL
Delta-X-Robot/Delta X 1 - M5x10 bolt-21.STL
Delta-X-Robot/Delta X 1 - M5x10 bolt-22.STL
Delta-X-Robot/Delta X 1 - M5x10 bolt-3.STL
Delta-X-Robot/Delta X 1 - M5x10 bolt-4.STL
Delta-X-Robot/Delta X 1 - M5x10 bolt-5.STL
Delta-X-Robot/Delta X 1 - M5x10 bolt-6.STL
Delta-X-Robot/Delta X 1 - M5x10 bolt-7.STL
Delta-X-Robot/Delta X 1 - M5x10 bolt-8.STL
Delta-X-Robot/Delta X 1 - M5x10 bolt-9.STL
Delta-X-Robot/Delta X 1 - MovingBase-4 Base-EndEffecterV2-1.STL
Delta-X-Robot/Delta X 1 - MovingBase-4 Joint Ball-4.STL
Delta-X-Robot/Delta X 1 - MovingBase-4 Joint Ball-5.STL
Delta-X-Robot/Delta X 1 - MovingBase-4 M4x60 thread-2.STL
Delta-X-Robot/Delta X 1 - MovingBase-4 vongdem3m-1.STL
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
