deltaxrobot/Delta-X-3D-Printed-Parts/(threads)

Thread 1 (2021-02-11):

File is missing

JIAYAZHOU, 2021-02-11:
Hello, I am learning DeltaX robot. But I found some xxx.STEP files are missing in the 3D printing part. For example, MainBox, Triangle angle..., these parts have only STL files, but no STEP files. Thank you.

Thread 2 (2022-04-08):

Missing CADs

nym, 2022-04-08:
The project seems to be missing CAD files for the frame (cube version, not robotfeet), conveyor(s), and slider.

If you could add those it would be most appreciated.

Thread 3 (2022-04-08):

Missing BOM for Vacuum

nym, 2022-04-08:
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

There doesn't seem to be any documentation for the vacuum parts, such as the above. What parts are used?
