deltaxrobot/Delta-X-3D-Printed-Parts/(commit log)

2022-04-01 Add Delta X1 - v2
    [3D Printing head.STEP, Axis4.STEP, Belt Tension 1.STL, Belt Tension 2.STL, Belt Tension Carrier 1.STL, Belt Tension Carrier 2.STL, Carrier - Stick.STEP, Carrier.STEP]
2023-01-11 added conveyor parts
    [Adjust-Tool.STL, ConveyorGearBox-Body.STL, ConveyorGearBox-Lid.STL, Roller.STL, RollerAxisHolder-Mirror.STL, RollerAxisHolder.STL, StepperWedge.STL]
2023-01-11 slider parts
    [BeltKeeper.STL, RollerHolder.STL, WheelHolder-1.STL, WheelHolder-2.STL, WheelHolder-3.STL]
2023-01-11 reconfig folder name
    [3D Printing head.STEP, Axis4 - Vacuum Bottom.STL, Axis4 - Vacuum Lib.STL, Axis4 Gripper Box.STL, Axis4 Gripper Lib.STL, Axis4 Gripper Top.STL, Axis4.STEP, Delta X 1 - 2020_Alu profile-1.STL]
2023-02-06 add axis 4 v2 parts
    [Axis4-Vacuum-Bottom-SV.stl, Base-1.stl, Base-2.stl, Base2.stl, Bearing.STL, VaccumBase-SV.STL]
2024-02-09 add stl file of pen holder
    [Pen Holder 1.STL, Pen Holder 2.STL]
2024-03-16 add tripod frame base
    [TripodBase.stl]
